alex-snigir/water-controller/README.md

# water-controller
Home Main Water Line Controller connects directly to primary water supply to monitor flow, detect leaks, and automatically shut off the water to prevent catastrophic property damage.
