alex-snigir/water-controller/WaterController_pio/README.txt

Project: WaterController

  Home Main Water Line Controller connects directly to primary water supply to monitor flow, 
  detect leaks, and automatically shut off the water to prevent catastrophic property damage.
 
  Versions:
    v1.00 build 20261031 - Initial version
    v1.00 build 20261108 - Lock Switch J7 (GPIO13, valve/lock) and software open ban valve_enable (NVS, valve_enable/set), valve/rejected
    v1.00 build 20261109 - LED4 tells rejected opens apart: 3 fast blinks "locked", 2 long blinks "disabled";
                           retained valve/open, valve/close, valve_enable/set deleted on MQTT connect, before subscribing

  TODO:
