alex-snigir/water-controller/doc/water-connection-project-summary.md

# WaterController — сводка проекта

Версия документа: 1.0 · Дата: 2026-10-20

> Контроллер главного водопровода дома: подключается к магистральному вводу воды, контролирует расход и давление, обнаруживает протечки и автоматически перекрывает воду, чтобы предотвратить серьёзный ущерб.

| | |
|---|---|
| Схема | `schematics/WaterController/WaterController.kicad_sch` (KiCad 10.0.3, 1 лист A4) |
| Нетлист | `schematics/WaterController/plot/WaterController.net` (экспорт 2026-11-13 23:04) |
| PDF схемы | `schematics/WaterController/plot/WaterController.pdf` |
| Прошивка | `WaterController_pio/` (PlatformIO, Arduino), `APP_VER = "1.00 build 20261031"` |
| Исходные заметки | `doc/WaterController - INFO.txt`, `doc/Water Connection.txt` |
| Плата (PCB) | не начата (`WaterController.kicad_pcb` пустой) |

---

## 1. Структура системы

```
          +12V от HLK-10M12 (отдельная плата) ──► J8 ──► F1 + D1 (защита)
              │
     ┌────────┼──────────────────────────────┬──────────────────────┐
     │        │                              │                      │
     │   LM2596 (MOD1) ──► 1N5817 (D2) ──► +5V                      │
     │                                       │                      │
     │      ┌────────────────────────────────┼─────────────┐        │
     │      │                                │             │        │
     │   ESP32-DevKitC-32U (U1)          ADS1115 (U4)   HV-сторона  │
     │   5V-пин → LDO → +3V3             VDD = 5V       Level       │
     │      │                                │          Shifter(U2) │
     │      │ IO21/IO22 (I2C, 3.3V) ──► U2 ──► SDA/SCL               │
     │      │ IO19/IO18 ──►|── D3/D4 ──────► IN1/IN2 ──► DRV8871 (U3)│
     │      │ SW1/SW2 (кнопки) ─► IN1/IN2    │                       │
     │      │ IO34/IO35 ◄─ R7/R8 ◄─ IN1/IN2  │                       │
     │      │ IO32/33/25/26 ─► LED1–LED4     │                       │
     │      │ IO5/IO15 ◄── J4/J5 (DS18B20)   │                       │
     │      │ IO21/IO22 ──► J6 (SHT41, 3.3V) │                       │
     │      │ IO13 ◄── J7 (Lock Switch)      │                       │
     │      │                                │             VM=+12V ─┘
     │      │                                │             OUT1/OUT2
     │      │                          A0 ◄── J2 ◄── SWP-300       │
     │      │                                       (питание +12V)  ▼
     │      │ IO23 ◄── U2 ◄── R13 ◄── J3 ◄── YF-B10 (+5V)    J1 ──► Кран CR01
     │      │                                                      (CWX-25S)
     │      │                                     LED5/LED6 (Open/Close) на J1
     │   Wi-Fi (внешняя антенна) ──► MQTT-брокер ──► Home Assistant
```

---

## 2. Оборудование

### 2.1 Микроконтроллер

| Параметр | Значение |
|---|---|
| Модуль | ESP32-WROOM-32U (разъём U.FL под внешнюю антенну) |
| Отладочная плата на схеме | ESP32-DevKitC-32U, 38 выводов (символ `_my_MC_Dev_Boards:ESP32-DEVKITC-32-38PINS`) |
| Питание | 5 В на вывод `5V` платы, 3.3 В получается встроенным LDO платы |
| Почему 5 В | 5 В — единое напряжение для периферии: ADS1115 питается от 5 В, чтобы диапазон его входа покрывал сигнал датчика давления 0–5 В |

### 2.2 Электрокран

| Параметр | Значение |
|---|---|
| Модель | CR01, 12 В, DN20 (3/4"), модель CWX-25S |
| Управление | 2 провода, направление — сменой полярности |
| Особенность | в открытом и закрытом положении ток не потребляет (сохраняет положение при пропадании питания) |
| Питание | 12 В |
| Мощность | < 2 Вт |
| Рабочий ток | < 80 мА (только во время хода) |
| Время полного хода | 5 с |
| Концевики | встроены: в крайних положениях кран сам обесточивает мотор |
| Обратная связь о положении | нет: 2-проводная модель, выводов состояния концевиков нет |

### 2.3 Электронный датчик давления

| Параметр | Значение |
|---|---|
| Модель | SWP-300, 0–10 бар, G1/2 |
| Подключение | 1/2" папа |
| Питание | 12–36 В DC (номинал 24 В); на схеме — **+12 В** |
| Выход | 0–5 В (линейно: 2 бар/В) |

### 2.4 Датчик расхода

| Параметр | Значение |
|---|---|
| Модель | YF-B10, 1", 2–50 л/мин |
| Питание | DC 3.5–24 В (датчик Холла, питание обязательно); на схеме — **+5V** (J3) |
| Выход | импульсы, 476 имп/л |
| Частота | при 50 л/мин ≈ 400 Гц; при 2 л/мин ≈ 16 Гц |

### 2.5 Механический манометр

Резьба 1/4" папа, ставится на тот же тройник, что и электронный датчик (визуальный контроль).

### 2.6 Датчики температуры и влажности

| Датчик | Где | Подключение | Назначение |
|---|---|---|---|
| DS18B20, герметичный зонд в гильзе | **Pipe** — на латунном фитинге или корпусе крана, под теплоизоляцией | J4, 1-Wire, GPIO5 | риск замерзания, нагрев воды |
| DS18B20, герметичный зонд | **Air** — воздух в большом уличном боксе, в тени, не касаясь трубы и стенок | J5, 1-Wire, GPIO15 | условия вокруг оборудования; примерная температура стенок для оценки конденсата |
| SHT41 (модуль на кабеле 10–20 см) | **Box** — воздух внутри коробки контроллера, вдали от HLK, LM2596, ESP32 | J6, I2C (0x44) | перегрев электроники, влажность, точка росы |
| SHTC3 | для испытаний вместо SHT41 | J6, I2C (0x70) | нагревателя нет |
| Датчик ESP32 | кристалл | — | только справочно (см. 4.7) |

### 2.7 Блок питания и корпус

| Параметр | Значение |
|---|---|
| Источник 12 В | Hi-Link **HLK-10M12** (AC → 12 В) на **отдельной монтажной плате**; к плате контроллера — двумя проводами через J8 (винтовой клеммник). LM2596 остаётся на плате контроллера |
| Корпус контроллера | закрытая коробка 12 × 17 × 9 см с платой контроллера и платой БП; стоит внутри большого уличного бокса со всей водяной системой |
| Рекомендация | **HLK-10M12**: пиковая нагрузка по 12 В ~4 Вт (ход крана + пик Wi-Fi) — почти весь номинал 5-ваттного модуля, а при высокой температуре допустимая мощность таких модулей снижается (кривую проверить в даташите Hi-Link) |
| Плата БП | клеммник 220 В (L, N), предохранитель T 0.5–1 А на L, варистор ~275 В AC (10D471 / 14D471), HLK-10M12, на выходе электролит 100–220 мкФ + 100 нФ (обвязку сверить с даташитом HLK-10M12); зазор между цепями 220 В и низковольтной частью ≥ 6 мм, лишние полосы и площадки монтажной платы разрезать, сторону 220 В закрыть |
| Тепло | в коробке выделяется ~1 Вт → примерно +5…10 °C к воздуху в боксе; летом закрытый бокс на солнце может нагреваться до 60 °C и выше — светлый бокс, тень, коробка не у солнечной стенки |

---

## 3. Гидравлическая схема подключения (из `Water Connection.txt`)

**Пиллер (на улице):** счётчик → обратный клапан (аль-хозер) → ручной кран → труба PEX25 до хацера.

**Хацер, версия 1 (по потоку воды):**

| # | Элемент | Резьба |
|---|---|---|
| 1 | Труба PEX25 | — |
| 2 | Переходник PEX25 → 3/4 | 3/4 мама → папа |
| 3 | Ручной кран | 3/4 мама → папа |
| 4 | **Электрокран CR01** | 3/4 мама → мама |
| 5 | Переходник 3/4 → 1" | 1" папа → папа |
| 6 | **Датчик расхода YF-B10** | 1" мама → мама |
| 7 | Переходник 1" → 3/4 | 3/4 папа → мама |
| 8 | Вассат (редуктор давления) | 3/4 папа → папа |
| 9 | Фильтр | 3/4 мама → мама |
| 10 | Ручной кран | 3/4 папа → мама |
| 11 | Тройник | 3/4 → 3/4 |
| 12 | Переходник 3/4 → PEX25 | 3/4 мама → мама |

**Отвод от тройника (п. 11):** тройник 3/4 + заглушка → переходник 3/4 → 1/2 → **электронный датчик давления** (1/2) и механический манометр (1/4).

Датчик давления стоит после редуктора и фильтра, то есть измеряет давление в домашней сети.

---

## 4. Электрическая схема (по нетлисту)

### 4.1 Перечень элементов

| Обозн. | Номинал / модуль | Футпринт | Назначение |
|---|---|---|---|
| J8 | PWR 12V, Conn_01x02 | винтовой клеммник MaiXu MX126, 5.0 мм (`TerminalBlock_MaiXu_MX126-5.0-02P`) | ввод 12 В от платы HLK-10M12: 1 — GND, 2 — +12V_IN |
| F1 | RXEF075 (самовосстанавливающийся предохранитель, 0.75 А удержания) | `Fuse:Fuse_Bourns_MF-RHT050`, шаг 5.1 мм — совпадает с RXEF075 | последовательно в +12V: +12V_IN → +12V |
| D1 | P6KE18A (TVS, однонаправленный) | DO-15 | +12V → GND (катод к +12V): гасит выбросы и вместе с F1 защищает от переполюсовки |
| MOD1 | LM2596 (модуль HW-411) | `_my_PSU_Modules:DC-DC Step Down LM2596 HW-411` | понижающий DC-DC 12 → 5 В; входной электролит модуля — 100 мкФ, 50 В |
| D2 | 1N5817 | DO-41 | развязка выхода LM2596 и шины +5V (защита от обратного тока при питании DevKit от USB) |
| U1 | ESP32-DevKitC-32U, 38 pin | `_my_MC_Dev_Boards:ESP-DEVKIT-32-38PINS` | МК |
| U2 | 4-канальный I2C Logic Level Converter | `_my_Generic_Modules:IIC_I2C_4-way_Logic_Level_Converter` | 3.3 В ↔ 5 В: канал 1 — сигнал датчика расхода, канал 2 — SCL, канал 3 — SDA; канал 4 свободен |
| U3 | DRV8871 H-Bridge Motor Driver Module | `_my_Generic_Modules:DRV8871 H-Bridge Motor Driver Module on perfboard` | драйвер электрокрана |
| U4 | ADS1115 (синий модуль) | `_my_ADC_DAC_Modules:ADS1115_Blue_Module_Horizontal` | АЦП 16 бит для датчика давления |
| J1 | Conn_01x02 | JST XH 2P, вертикальный (B2B) | кран CR01: 1 — Valve_Red (OUT1), 2 — Valve_Black (OUT2) |
| J2 | Conn_01x03 | JST XH 3P, вертикальный (B3B) | датчик давления: 1 — GND, 2 — +12V, 3 — сигнал |
| J3 | Conn_01x03 | JST XH 3P, вертикальный (B3B) | датчик расхода YF-B10: 1 — GND, 2 — +5V, 3 — сигнал |
| C2 | 470 мкФ | радиальный D8 | +5V (у вывода 5V DevKit) |
| C1 | 100 нФ | керамика | +5V (у вывода 5V DevKit) |
| C3 | 470 мкФ | радиальный D8 | +3V3 |
| C4 | 100 нФ | керамика | +3V3 |
| C7 | 100 нФ | керамика | VDD ADS1115 |
| C5 | 100 мкФ, 35 В | радиальный D8 | VM DRV8871 (+12V); 35 В — с запасом выше ограничения D1 (~25 В) |
| C6 | 100 нФ | керамика | VM DRV8871 (+12V) |
| R1 | 4.7 кОм | R_Axial DIN0207, P7.62 мм | последовательный резистор в линии сигнала датчика давления: ограничение тока через защитные диоды A0, RC-фильтр с C8 |
| R2 | 100 кОм | R_Axial DIN0207, P7.62 мм | подтяжка сигнала датчика давления к GND (со стороны J2): определённый уровень 0 В при отключённом датчике |
| C8 | 100 нФ | керамика | фильтр на входе A0 ADS1115 (A0 → GND), RC-фильтр с R1 |
| R3 | 47 кОм | R_Axial DIN0207, P7.62 мм | подтяжка valve_close (IO18 / DRV8871 IN2) к GND |
| R4 | 47 кОм | R_Axial DIN0207, P7.62 мм | подтяжка valve_open (IO19 / DRV8871 IN1) к GND |
| D3 | 1N5817 | DO-41 | развязка IO19 → IN1: GPIO может только подать 1, кнопка SW1 не замыкается на выход GPIO |
| D4 | 1N5817 | DO-41 | развязка IO18 → IN2: то же для SW2 |
| SW1 | SW_Push (Open) | JST XH 2P (B2B-XH-A), вертикальный | выносная кнопка без фиксации «открыть»: подаёт питание кнопок на IN1 |
| SW2 | SW_Push (Close) | JST XH 2P (B2B-XH-A), вертикальный | выносная кнопка без фиксации «закрыть»: подаёт питание кнопок на IN2 |
| R5 | 7.5 кОм | R_Axial DIN0207, P7.62 мм | верхнее плечо делителя питания кнопок (от +5V); ограничение тока при замыкании провода кнопки |
| R6 | 15 кОм | R_Axial DIN0207, P7.62 мм | нижнее плечо делителя питания кнопок (≈ 3.33 В) |
| C9 | 100 нФ | керамика | фильтр узла питания кнопок (R5/R6) |
| C10 | 100 нФ | керамика | фильтр входа IN1 (помехи, статика, дребезг SW1) |
| C11 | 100 нФ | керамика | фильтр входа IN2 (помехи, статика, дребезг SW2) |
| R7 | 10 кОм | R_Axial DIN0207, P7.62 мм | чтение состояния IN1 на IO34; ограничение тока в защитные диоды ESP32 |
| R8 | 10 кОм | R_Axial DIN0207, P7.62 мм | чтение состояния IN2 на IO35; ограничение тока в защитные диоды ESP32 |
| D5 | LED1 (WIFI), синий | LED 5 мм, угловой (LED_D5.0mm_Horizontal) | статус Wi-Fi/MQTT, катод на IO32 |
| D6 | LED2 (Valve), зелёный | LED 5 мм, угловой | состояние крана, катод на IO33 |
| D7 | LED3 (Flow), жёлтый | LED 5 мм, угловой | расход, катод на IO25 |
| D8 | LED4 (Error), красный | LED 5 мм, угловой | ошибка, катод на IO26 |
| R9 | 200 Ом | `_my_Resistors:R_Axial_DIN0207…P10.16` | токоограничивающий для D5 (от +3V3) |
| R10 | 240 Ом | `_my_Resistors:R_Axial_DIN0207…P10.16` | токоограничивающий для D6 (от +3V3) |
| R11 | 510 Ом | `_my_Resistors:R_Axial_DIN0207…P10.16` | токоограничивающий для D7 (от +3V3) |
| R12 | 510 Ом | `_my_Resistors:R_Axial_DIN0207…P10.16` | токоограничивающий для D8 (от +3V3) |
| R13 | 1 кОм | R_Axial DIN0207, P7.62 мм | последовательный резистор в сигнале датчика расхода: RC-фильтр с C12, ограничение тока при статике |
| C12 | 10 нФ | керамика | фильтр сигнала датчика расхода (Water_Flow → GND) |
| D9 | LED5 (Open), зелёный | LED 5 мм, угловой | индикация команды «открыть» на выходе DRV8871 (OUT1 → OUT2) |
| D10 | LED6 (Close), красный | LED 5 мм, угловой | индикация команды «закрыть» на выходе DRV8871 (OUT2 → OUT1) |
| R14 | 2.2 кОм | `_my_Resistors:R_Axial_DIN0207…P10.16` | общий токоограничивающий для D9/D10 (от выхода крана 12 В) |
| J4 | Conn_01x03 | штыри 1×3, 2.54 мм (Dupont) | зонд DS18B20 Pipe: 1 — DQ (IO5), 2 — GND, 3 — +3V3 |
| J5 | Conn_01x03 | штыри 1×3, 2.54 мм (Dupont) | зонд DS18B20 Air: 1 — DQ (IO15), 2 — GND, 3 — +3V3 |
| J6 | Conn_01x04 | JST XH 4P, вертикальный (B4B) | модуль SHT41 (Box): 1 — +3V3, 2 — GND, 3 — SCL (IO22), 4 — SDA (IO21) |
| R15 | 4.7 кОм | `_my_Resistors:R_Axial_DIN0207…P10.16` | подтяжка 1-Wire DQ (IO5, J4) к +3V3 |
| R16 | 4.7 кОм | `_my_Resistors:R_Axial_DIN0207…P10.16` | подтяжка 1-Wire DQ (IO15, J5) к +3V3 |
| J7 | Conn_02x02_Odd_Even | штыри 2×2, 2.54 мм (`PinHeader_2x02_P2.54mm_Vertical`) | Lock Switch: 1 — узел IN1, 2 — IN1 у DRV8871, 3 — LOCK (→ R19 → IO13), 4 — GND; норма — перемычки 1–2 и 3–4 |
| R17 | 47 кОм | R_Axial DIN0207, P7.62 мм | подтяжка IN1 к GND на стороне DRV8871 (при разомкнутом J7 1–2) |
| C13 | 100 нФ | керамика | фильтр IN1 на стороне DRV8871 |
| R18 | 10 кОм | R_Axial DIN0207, P7.62 мм | подтяжка LOCK (IO13) к +3V3 |
| R19 | 1 кОм | R_Axial DIN0207, P7.62 мм | последовательно в линии LOCK: ограничение тока статики с кабеля переключателя |
| C14 | 100 нФ | керамика | фильтр IO13 на GND (с R19: τ = 0.1 мс) |
| NT1, NT2 | NetTie_2 | — (on_board = no, in_bom = no) | только рисунок перемычек J7 1–2 и 3–4; в нетлист и на плату не попадают |

### 4.2 Цепи питания

| Цепь | Источник | Потребители |
|---|---|---|
| +12V_IN | J8.2 (от HLK-10M12) | только F1 |
| +12V | после F1 | D1, MOD1 IN+, U3 VM, J2.2 (питание датчика давления), C5, C6 |
| +5V | MOD1 OUT+ через D2 | U1 `5V` (вывод 19), U2 HV, U4 VDD, R5 (питание кнопок), J3.2 (питание YF-B10), C1, C2, C7 |
| +3V3 | LDO на плате DevKit (U1 вывод 1) | U2 LV, R9–R12 (светодиоды D5–D8), J4.3/J5.3 (DS18B20), R15/R16, J6.1 (SHT41), R18 (LOCK), C3, C4 |
| GND | общая (J8.1) | все модули; U1 выводы 14, 32, 38 |

PWR_FLAG стоят на +12V_IN, +12V (после F1), +5V (после D2) и GND: F1 и D2 пассивные, и без флага после них ERC считал бы, что у входов питания MOD1, U3 и U1 нет источника.

### 4.2.1 Ввод питания 12 В и защита (J8, F1, D1)

```
HLK-10M12 ── J8.2 ── +12V_IN ──[F1 RXEF075]──┬──────────┬──────────┬──────────┬──── +12V
(отдельная                                    │          │          │          │
 плата)                                    D1 P6KE18A  MOD1 IN+   U3 VM      J2.2
                                              │       (LM2596)  (DRV8871,  (датчик давления)
                                              │                  C5, C6)
          ── J8.1 ── GND ─────────────────────┴──────────────────────────────────── GND
```

| Режим | Что происходит |
|---|---|
| Обычная работа | D1 закрыт (рабочее напряжение P6KE18A без утечки — 15.3 В, запас ~3 В над 12.0–12.5 В от HLK); падение на F1 ≈ 0.1 В при ~0.35 А |
| Выброс с длинных кабелей к крану и датчику | D1 ограничивает напряжение на шине: начинает открываться при 17.1–18.9 В, при пиковом токе ограничивает на ~25 В |
| Перепутана полярность на J8 | D1 открывается в прямом направлении и замыкает вход: срабатывает F1 (и ограничение тока HLK), на схеме не больше ~−1 В |

- **Порядок важен:** D1 — сразу после F1, все нагрузки — после D1. TVS до предохранителя при переполюсовке пропускал бы ток мимо F1.
- Последовательный диод от переполюсовки не ставится: падение 0.3–0.5 В опустило бы питание датчика давления ниже его минимума 12 В.
- **Выдерживают ~25 В на шине:** DRV8871 (VM до 45 В), LM2596 (до 40 В), SWP-300 (12–36 В), C5 (35 В), входной электролит модуля LM2596 (50 В), C6 (керамика, обычно 50 В).
- **Почему клеммник, а не XH:** XH 2P уже стоят на J1 (кран) и SW1/SW2 (кнопки) — кабель 12 В вошёл бы в них (12 В на входы DRV8871 сожгли бы драйвер). Клеммник с XH не перепутать; от переполюсовки защищают F1 и D1.
- **Шелкография:** у J8 крупно «+12V» и «GND», лучше со стрелкой полярности.
- **Разводка:** J8, F1 и D1 — рядом; путь от D1 к U3 VM и C5 — коротким и широким проводником (ток мотора крана).

### 4.3 Сигнальные цепи

| Цепь | От | Через | К |
|---|---|---|---|
| I2C SCL | U1 IO22 (выв. 36) | U2 LV2 → HV2; на стороне LV — J6.3 | U4 SCL, SHT41 SCL |
| I2C SDA | U1 IO21 (выв. 33) | U2 LV3 → HV3; на стороне LV — J6.4 | U4 SDA, SHT41 SDA |
| valve_open | U1 IO19 (выв. 31) | D3; на узле IN1 — R4 47 кОм и C10 100 нФ на GND, SW1 | U3 IN1 |
| valve_close | U1 IO18 (выв. 30) | D4; на узле IN2 — R3 47 кОм и C11 100 нФ на GND, SW2 | U3 IN2 |
| Питание кнопок | +5V | делитель R5 7.5 кОм / R6 15 кОм, C9 100 нФ на GND | SW1.2, SW2.2 |
| IN1 → DRV8871 | узел IN1 (Net-(D3-K), J7.1) | J7 1–2 (перемычка или контакт A переключателя); на стороне DRV8871 — R17 47 кОм и C13 100 нФ на GND | U3 IN1 (Net-(J7-Pin_2)) |
| LOCK | J7.3 | R19 1 кОм; R18 10 кОм к +3V3; C14 100 нФ на GND; J7.4 — GND | U1 IO13 (выв. 15), вход |
| Состояние IN1 | узел IN1 (Net-(D3-K)) | R7 10 кОм | U1 IO34 (выв. 5), вход |
| Состояние IN2 | узел IN2 (Net-(D4-K)) | R8 10 кОм | U1 IO35 (выв. 6), вход |
| Кран | U3 OUT1 / OUT2 | — | J1.1 / J1.2 |
| LED5/LED6 | U3 OUT1 | R14 2.2 кОм → D9 / D10 (встречно-параллельно) | U3 OUT2 |
| LED1–LED4 | +3V3 | R9–R12 → анод D5–D8 | катоды на U1 IO32, IO33, IO25, IO26 |
| Давление | J2.3 | R2 на GND → R1 → C8 на GND | U4 A0 |
| Расход (Water_Flow) | J3.3 | R13 1 кОм → C12 10 нФ на GND → U2 HV1 → LV1 | U1 IO23 (выв. 37) |
| 1-Wire Pipe | J4.1 | R15 4.7 кОм к +3V3 | U1 IO5 (выв. 29) |
| 1-Wire Air | J5.1 | R16 4.7 кОм к +3V3 | U1 IO15 (выв. 23) |

Не подключены: U2 LV4/HV4 (свободный канал преобразователя уровней); U4 A1–A3, ADDR (на синем модуле есть подтяжка к GND → адрес 0x48, совпадает с `ADS1X15_ADDRESS` в прошивке), ALRT; остальные GPIO ESP32 (см. раздел 9).

### 4.3.1 Входная цепь датчика давления (R1, R2, C8)

```
J2.3 (сигнал) ──┬──[R1 4.7 кОм]──┬──► A0 (U4, ADS1115)
                │                │
            [R2 100 кОм]     C8 100 нФ
                │                │
GND ────────────┴────────────────┴──► GND (U4)
```

| Цепь (нетлист) | Узлы |
|---|---|
| Net-(J2-Pin_3) | J2.3, R1.1, R2.1 |
| Net-(U4-A0) | R1.2, C8.2, U4.7 (A0) |
| GND | J2.1, R2.2, C8.1, U4.2 |

| Элемент | Назначение | Расчёт |
|---|---|---|
| R1 4.7 кОм | Ограничивает ток через внутренние защитные диоды A0 (допустимо ≤ 10 мА), если на сигнальный провод попадёт +12 В (ошибка в разъёме, повреждение кабеля) | (12 − 5.3) В / 4.7 кОм ≈ 1.4 мА; мощность на R1 ≈ 10 мВт |
| C8 100 нФ | Вместе с R1 — RC-фильтр нижних частот: подавляет помехи с длинного кабеля (мотор крана, сеть, Wi-Fi) и отдаёт заряд на коммутируемый вход ADS1115 при каждом преобразовании. Ставится у вывода A0, земля — к GND модуля ADS1115 | fc = 1 / (2π · 4.7 кОм · 100 нФ) ≈ 340 Гц; установление 5τ ≈ 2.4 мс < 8 мс (одно преобразование при 128 SPS) |
| R2 100 кОм | Подтяжка к GND со стороны разъёма: при отключённом датчике вход не «плавает», а показывает 0 В | нагрузка на выход датчика 100 кОм — пренебрежимо мала |

- Ошибка измерения от R1: входное сопротивление ADS1115 на диапазоне ±6.144 В ~10 МОм → ≈ 0.05 %, меньше погрешности датчика.
- При перевёрнутом 3-контактном разъёме +12 В остаётся на среднем контакте и на A0 не попадает.
- Опционально: сдвоенный диод Шоттки BAT54S в узел A0 (на +5V и GND) — внешняя фиксация перенапряжения вместо внутренних диодов ADS1115. Стабилитрон 5.1 В не рекомендуется: его ток утечки около 5 В занижает показания у верхней границы шкалы (10 бар).
- Обрыв датчика по-прежнему не отличим от 0 бар (выход 0–5 В); R2 только устраняет «плавающий» вход.

### 4.3.2 Входная цепь датчика расхода (J3, R13, C12, U2 канал 1)

```
J3.3 ──[R13 1k]──┬── U2 HV1 ══ LV1 ──► IO23
                 │
              C12 10n
                 │
J3.1 ────────────┴── GND        J3.2 ── +5V (питание YF-B10)
```

| Цепь (нетлист) | Узлы |
|---|---|
| Net-(J3-Pin_3) | J3.3, R13.1 |
| /Water_Flow | R13.2, C12.2, U2 HV1 |
| Net-(U1-IO23) | U2 LV1, U1 IO23 |
| +5V | J3.2 |
| GND | J3.1, C12.1 |

| Элемент | Назначение |
|---|---|
| +5V на J3.2 | Питание датчика Холла YF-B10 (3.5–24 В). +3V3 не подходит (ниже минимума 3.5 В); +12V возможен, но выход датчика тогда доходит до 12 В — без пользы и с большим риском |
| U2, канал 1 | Приводит сигнал 0/5 В к 0/3.3 В для IO23 (GPIO ESP32 не выдерживают 5 В). Подтяжки 10 кОм модуля к 5 В (HV) и к 3.3 В (LV) обеспечивают работу и с выходом «открытый коллектор», и с выходом, который сам выдаёт 0/5 В. Сигнал не инвертируется |
| R13 1 кОм | Вместе с C12 — фильтр помех с кабеля; ограничивает ток при статическом разряде |
| C12 10 нФ | Фильтр сигнала на стороне HV |

| Параметр | Значение |
|---|---|
| Частота сигнала | 476 имп/л: ≈ 16 Гц при 2 л/мин, ≈ 400 Гц при 50 л/мин (полупериод 1.25 мс) |
| Фронт вниз (через R13) | τ = 1 кОм · 10 нФ ≈ 10 мкс |
| Фронт вверх (через подтяжку 10 кОм модуля U2) | τ ≈ 100 мкс — в 12 раз меньше полупериода на 400 Гц |
| Уровень 0 при выходе «открытый коллектор» | 5 В · 1 кОм / (10 кОм + 1 кОм) ≈ 0.45 В — ниже порога 0 у ESP32 (0.83 В) |
| Ток датчика | ≤ ~15 мА от +5V |

- Прошивка: `WATER_FLOW_GPIO 23`, `INPUT_PULLUP` (не мешает — подтяжка к 3.3 В уже есть на модуле), прерывание по `FALLING` — подходят.
- Почему IO23, а не IO17: GPIO17 по умолчанию — TX у UART2 (подписан TX2 на DevKit) и оставлен под Serial2 для второго ESP; кроме того, на модуле ESP32-WROVER (с PSRAM) GPIO16/17 заняты памятью, а IO23 свободен. IO23 — не strapping-вывод, без подтяжек при сбросе, поддерживает прерывание.
- Тип выхода конкретного экземпляра можно проверить: питание 5 В, сигнал ни к чему не подключён, прокрутить крыльчатку. Меняется 0/5 В — выход сам выдаёт уровень; «плавает» или около 0 — открытый коллектор. Схема работает в обоих случаях.
- J2 и J3 — одинаковые разъёмы JST XH 3P с одинаковым порядком контактов, но на среднем контакте разное питание: 12 В и 5 В. Перепутывание неопасно (YF-B10 выдерживает 12 В, ток в A0 ограничит R1; SWP-300 при 5 В просто не будет работать), но разъёмы стоит подписать на шелкографии: «PRESS 12V» / «FLOW 5V».

### 4.4 Логика управления краном (DRV8871)

Входы IN1/IN2 управляются от IO19/IO18 без преобразователя уровней, через диоды Шоттки D3/D4: порог VIH у DRV8871 ≈ 1.5 В, уровня ≈ 3.1 В (3.3 В минус падение на диоде) достаточно. Параллельно МК входами управляют кнопки SW1/SW2 (см. 4.4.1). Линия IN1 проходит к DRV8871 через J7 1–2 (Lock Switch, см. 4.4.3); IN2 — напрямую.

| IN1 (IO19 или SW1) | IN2 (IO18 или SW2) | Выход | Действие |
|---|---|---|---|
| 0 | 0 | Z (coast), через ~1 мс — сон | стоп |
| 1 | 0 | OUT1 = +12V, OUT2 = GND | открытие |
| 0 | 1 | OUT1 = GND, OUT2 = +12V | закрытие |
| 1 | 1 | оба на GND (brake) | стоп (торможение) |

Во время сброса/загрузки ESP32 выводы IO18/IO19 находятся в высокоимпедансном состоянии (это не strapping-выводы), внешние подтяжки R4 (IN1) и R3 (IN2) по 47 кОм к GND, параллельно внутренним подтяжкам DRV8871, выставляют оба входа в 0 (D3/D4 при этом закрыты) → режим coast, затем сон → **кран при перезагрузке не двигается**. Это корректное безопасное поведение.

R3/R4 задают уровень 0 и тогда, когда плата ESP32 не установлена, и не зависят от наличия внутренних подтяжек в конкретном модуле DRV8871; кроме того, они повышают помехоустойчивость входов. Нагрузка на GPIO в состоянии 1: 3.3 В / 47 кОм ≈ 70 мкА на каждый вывод (вместе с внутренней подтяжкой DRV8871 — порядка 0.1 мА), что пренебрежимо мало.

### 4.4.1 Ручное управление краном (SW1, SW2, D3, D4, R3–R8, C9–C11)

Реализует требование `INFO.txt` «Ability to open/close Electrical Water Valve without MC (phisical buttons)»: выносные кнопки без фиксации подают 1 прямо на входы DRV8871, минуя ESP32. Ручное управление работает, даже если ESP32 завис, не загружен или плата DevKit не установлена: питание кнопок берётся от +5V (LM2596), а не от LDO DevKit.

```
                      +5V
                       │
                   [R5 7.5k]
                       │  ≈ 3.33 В
              ┌────────┼────────┬───────────────┐
              │        │        │               │
          [R6 15k]  C9 100n   [SW1 Open]     [SW2 Close]
              │        │        │               │
             GND      GND       │               │
                                │               │
IO19 ──►|── D3 ─────────────────┼──► IN1 (U3)   │
                                │               │
                 IO34 ◄─[R7 10k]┤               │
                        R4 47k ─┤               │
                       C10 100n ┘ → GND         │
                                                │
IO18 ──►|── D4 ─────────────────────────────────┼──► IN2 (U3)
                                                │
                                 IO35 ◄─[R8 10k]┤
                                        R3 47k ─┤
                                       C11 100n ┘ → GND
```

| Цепь (нетлист) | Узлы |
|---|---|
| /valve_open | U1 IO19, D3 A |
| Net-(D3-K) — IN1 | D3 K, R4, C10, R7.2, SW1.1, U3 IN1 |
| /valve_close | U1 IO18, D4 A |
| Net-(D4-K) — IN2 | D4 K, R3, C11, R8.1, SW2.1, U3 IN2 |
| Net-(C9-Pad1) — питание кнопок | R5.2, R6.1, C9, SW1.2, SW2.2 |
| /IO34 | U1 IO34, R7.1 |
| /IO35 | U1 IO35, R8.2 |
| +5V | R5.1 |
| GND | R3.2, R4.2, R6.2, C9, C10, C11 |

**Назначение элементов**

| Элемент | Назначение |
|---|---|
| D3, D4 (1N5817) | GPIO может только подать 1 на IN, но не притянуть его к 0. Если кнопка нажата при GPIO = 0, диод закрыт и кнопка не замыкается на выход GPIO. Заодно диод не пропускает на GPIO напряжение выше 3.3 В. Диод со стороны кнопки не нужен: кнопка либо разомкнута, либо подаёт то же питание кнопок |
| R3, R4 (47 кОм) | Подтяжка IN2/IN1 к 0, когда GPIO = 0 (через закрытый диод GPIO вход к 0 не притянет), при загрузке ESP32 и при отпущенной кнопке |
| R5, R6 (7.5 / 15 кОм) | Делитель от +5V: питание кнопок ≈ 3.33 В, независимо от LDO DevKit. R6 = 15 кОм выбран так, чтобы при нажатии уровень на IN был с запасом выше порога 1 у ESP32 (чтение через IO34/IO35). R5 ограничивает ток, если провод кнопки замкнёт на GND |
| C9 (100 нФ) | Фильтр узла питания кнопок; при нажатии отдаёт заряд в C10/C11 |
| C10, C11 (100 нФ) | Фильтр входов IN1/IN2 от наводок и статики с проводов выносных кнопок, подавление дребезга контактов |
| R7, R8 (10 кОм) | Подключают узлы IN1/IN2 к входам IO34/IO35 для чтения состояния. Ограничивают ток в защитные диоды ESP32 при статике с проводов кнопок. На уровень узла не влияют (вход GPIO высокоомный). Подтяжки для IO34/IO35 не нужны — их роль выполняют R4/R3 |
| SW1, SW2 | Кнопки без фиксации, разъёмы JST XH 2P: pin 1 — IN, pin 2 — питание кнопок. Тумблер с фиксацией не годится: в положении OPEN вход IN1 постоянно в 1, и при протечке команда МК на закрытие даст только brake — кран не закроется |

**Уровни** (порог DRV8871: VIH ≈ 1.5 В, VIL ≈ 0.5 В; порог ESP32: VIH = 0.75 · 3.3 ≈ 2.48 В, VIL = 0.25 · 3.3 ≈ 0.83 В)

| Режим | IN / IO34 (IO35) | Запас до VIH ESP32 |
|---|---|---|
| Питание кнопок, кнопки отпущены | 5 · 15 / (7.5 + 15) ≈ 3.33 В | — |
| GPIO = 1 (через D3/D4; падение на 1N5817 при ~0.1 мА ≈ 0.15–0.2 В) | ≈ 3.1 В | ≈ 0.6 В |
| Нажата одна кнопка (R6 ∥ R4 ∥ внутренняя подтяжка DRV8871 ~100 кОм ≈ 10.2 кОм) | ≈ 2.9 В (≈ 3.0 В без внутренней подтяжки) | ≈ 0.4 В |
| Нажаты обе кнопки | ≈ 2.5 В на обоих входах → brake, кран стоит | ≈ 0.07 В — на грани, но режим и так нерабочий |
| Всё отпущено, GPIO = 0 | 0 В (R3/R4) | — |

| Параметр | Значение |
|---|---|
| Запас по 1 для DRV8871 | более 1 В во всех режимах |
| Максимум на IO34/IO35 | ≤ 3.3 В |
| Обратное напряжение на D3/D4 (кнопка нажата, GPIO = 0) | ≈ 2.9 В, ток утечки — единицы мкА |
| Ток при замыкании провода кнопки на GND | 5 В / 7.5 кОм ≈ 0.67 мА — питание ESP32 не просядет |
| Постоянный ток делителя | 5 В / 22.5 кОм ≈ 0.22 мА |

**Динамика**

| Событие | Что происходит | Время |
|---|---|---|
| МК даёт 1 | GPIO заряжает C10/C11 через открытый диод | микросекунды |
| МК даёт 0 | Диод закрыт, C10/C11 разряжаются через R4/R3 ∥ внутреннюю подтяжку (≈ 32 кОм), τ ≈ 3.2 мс | ниже VIL ESP32 (0.83 В) через ≈ 4–6 мс; ниже VIL DRV8871 (0.5 В) через ≈ 6–9 мс |
| Нажатие кнопки | C9 делит заряд с C10 — вход сразу ≈ 1.7 В, затем дозаряд через R5, τ ≈ 0.9 мс | до ≈ 2.9 В за ≈ 2–3 мс |
| Отпускание кнопки | Разряд через R4/R3 | ≈ 6–9 мс |
| Узел питания кнопок | R5 ∥ R6 = 5 кОм с C9, τ ≈ 0.5 мс | фильтр помех на проводе |

На входах IN частота среза фильтра около 50 Гц: короткие наводки на кабеле кнопок не доходят до порога 1.5 В.

**Поведение**

- Кран движется, пока кнопка нажата. У CR01 есть встроенные концевики: кнопку можно держать до конца хода, в крайнем положении кран обесточится сам.
- Нажатие кнопки во время встречного хода по команде МК → brake на ~30 мс (антидребезг), затем прошивка снимает свой выход, и кран идёт по кнопке. Команды при нажатой кнопке игнорируются. Обе кнопки сразу → brake, кран стоит. Это безопасно.
- Задержка остановки 6–9 мс из-за C10/C11 ни на что не влияет: CR01 останавливается концевиками, прошивка — по таймеру 7 с.
- При реверсе прошивка снимает выход и включает противоположный через 20 мс (`VALVE_REVERSE_PAUSE_MS`, без блокировки `loop()`): за это время C10/C11 разряжаются, поэтому brake на 1–9 мс, когда оба входа в 1, не возникает.

**Чтение состояния прошивкой (IO34/IO35)**

| IO34 (IN1) | IO19 (свой выход) | Значит |
|---|---|---|
| 0 | 0 | кнопка Open не нажата |
| 1 | 0 | нажата кнопка Open |
| 1 | 1 | кран открывает МК |
| 0 | 1 | ошибка: выход в 1, а на узле 0 (обрыв D3, КЗ узла IN1 на GND) |

Для IO35 / IO18 (Close) — аналогично. Требования к прошивке:

- **Маскирование после выключения выхода.** Когда МК переводит IO19/IO18 в 0, C10/C11 разряжаются, и ≈ 4–6 мс вход остаётся в 1. Чтобы хвост собственной команды не был принят за нажатие, после выключения выхода вход нужно игнорировать ~20 мс.
- **Антидребезг:** 20–50 мс программно (C10/C11 уже сглаживают основной дребезг).
- GPIO34/35 — только входы, без внутренних подтяжек: `pinMode(VALVE_OPEN_STATUS, INPUT)`, `pinMode(VALVE_CLOSE_STATUS, INPUT)` (макросы в `Application.h`).
- Реализовано в `valve.cpp` (см. 7.2, п. 14).

**Размещение на плате:** C10/C11 — рядом с разъёмами SW1/SW2, куда приходит провод кнопки, чтобы статический разряд уходил в конденсатор раньше, чем дойдёт до DRV8871; C9 — рядом с R5/R6; R7/R8 — ближе к выводам IO34/IO35. Порядок контактов SW1/SW2 (pin 1 — IN, pin 2 — питание кнопок) подписать на шелкографии.

### 4.4.2 Индикация команды на кран (LED5, LED6: D9, D10, R14)

```
OUT1 ──[R14 2.2k]──┬──►|── D9  LED5 (Open, зелёный)  ──┬── OUT2
                   └──|◄── D10 LED6 (Close, красный) ──┘
```

| Цепь (нетлист) | Узлы |
|---|---|
| Net-(J1-Pin_1) — OUT1 | U3 OUT1, J1.1, R14.2 |
| Net-(D10-K) | R14.1, D9 A, D10 K |
| Net-(D10-A) — OUT2 | U3 OUT2, J1.2, D9 K, D10 A |

| Режим DRV8871 | Горит | Ток |
|---|---|---|
| Open: OUT1 = +12V, OUT2 = GND | D9 LED5 (Open) | (12 − 2.0) / 2.2 кОм ≈ 4.5 мА |
| Close: OUT2 = +12V, OUT1 = GND | D10 LED6 (Close) | ≈ 4.5 мА |
| Coast / сон / brake | ничего | 0 |

- Светодиоды стоят на выходе DRV8871, поэтому показывают команду независимо от источника — кнопка SW1/SW2 или МК — и не нагружают логические узлы IN1/IN2. Подключение к узлам IN через 240 Ом (первый вариант) «садило» узел при нажатии кнопки до ≈ 1.8–2.0 В: IO34/IO35 переставали видеть нажатие, а запас DRV8871 падал до 0.3–0.5 В.
- Обратное напряжение на погашенном светодиоде равно падению на горящем (≈ 2 В) — меньше допустимых 5 В.
- Мощность на R14 ≈ 45 мВт; добавка к току DRV8871 несущественна.
- Светодиоды показывают поданное напряжение, а не движение крана: когда встроенный концевик CR01 обесточит мотор, светодиод горит, пока подана команда (до 7 с от прошивки или пока нажата кнопка).

### 4.4.3 Блокировка открытия — Lock Switch (J7, R17–R19, C13, C14)

Назначение: физически запретить открытие крана — и командой МК, и кнопкой SW1. Закрыть кран можно всегда. Случаи: работа сантехника после крана, долгий отъезд, защита от ошибочных или случайных команд (Home Assistant, retained-сообщение, ошибка прошивки). Для ремонта по-прежнему надёжнее всего ручной шаровой кран перед электрокраном.

```
Узел IN1 (D3, SW1, R4, C10, R7) ── J7.1 ○─┐ A ○─ J7.2 ──┬────────── U3 IN1
                                           │             ├─[R17 47k]── GND
                                           │             └─[C13 100n]─ GND
                                           │ (механически связаны)
+3V3 ──[R18 10k]──┬──[R19 1k]── J7.3 ○─────┘ B ○─ J7.4 ── GND
                  └─[C14 100n]─ GND
                  │
                IO13
```

| Цепь (нетлист) | Узлы |
|---|---|
| Net-(D3-K) — узел IN1 | D3 K, SW1.1, R4, C10, R7, **J7.1** |
| Net-(J7-Pin_2) — IN1 у DRV8871 | **J7.2**, U3 IN1, R17, C13 |
| Net-(J7-Pin_3) — LOCK | **J7.3**, R19 |
| /IO13 | U1 IO13, R19, R18, C14 |
| GND | **J7.4**, R17, C13, C14 … |

**Работа**

| J7 | IN1 к DRV8871 | IO13 | Состояние |
|---|---|---|---|
| перемычки 1–2 и 3–4 / переключатель в «Normal» | подключён | **0** | открытие разрешено |
| перемычек нет / переключатель в «LOCK» | оторван (R17 держит 0) | **1** (R18) | открытие невозможно ни МК, ни кнопкой SW1; закрытие работает |
| кабель переключателя выдернут или оборван | оторван | **1** | то же, что LOCK — прошивка не «думает», что открывает, когда открыть нельзя |

- Выносной переключатель — **DPST** (две независимые группы контактов, механически связанные): группа A разрывает IN1 (J7 1–2), группа B соединяет LOCK с GND (J7 3–4). Кабель — 4 провода с колодкой Dupont 2×2.
- Блокируется только IN1 (открытие); IN2 (закрытие) идёт мимо J7.
- Узел IN1 со стороны кнопки цел и при блокировке: IO34 видит нажатие SW1, но кран не движется; LED5 (Open) не загорается — наглядная обратная связь.
- R17/C13 нужны, потому что при разомкнутом J7 1–2 вывод IN1 у DRV8871 отрезан от R4/C10; без них остаётся только внутренняя подтяжка DRV8871 (~100 кОм) без фильтра — выносной провод мог бы наводкой кратко поднять IN1 выше ~1.5 В.
- Распределение контактов безопасно при ошибке: если перемычки надеть вертикально (1–3, 2–4), IN1 у DRV8871 окажется на GND (кран не откроется), а IO13 = 1 («заблокировано»).
- **NT1/NT2** — Net Tie без футпринта и с «on_board» = no: только рисунок перемычек, в нетлист не попадают (цепи J7.1/J7.2 и J7.3/J7.4 раздельны — так и нужно). Футпринт им не назначать: на плате появилась бы постоянная перемычка медью, и J7 потерял бы смысл.
- **При сборке:** без джамперов на J7 кран не откроется, а прошивка покажет `locked` — надеть перемычки 1–2 и 3–4 сразу.
- **Шелкография:** «LOCK», две горизонтальные чёрточки на месте перемычек; на схеме у J7 — заметка «Normal: jumpers on 1–2 and 3–4 / LOCK: remove jumpers or connect DPST switch».
- Ограничение: если перемычки стоят несогласованно (одна снята), состояние IO13 не совпадёт с реальным состоянием IN1. Прошивка это обнаружить не может (нет датчика положения); с переключателем DPST такого не бывает.
- **Ошибки монтажа, найденные на макете** (схема и нетлист верны, исправлено 20261109) — при разводке и сборке платы проверить эти соединения:
  - J7.3 не был соединён с R19 → IO13 всегда 1, прошивка всегда показывала `locked` (безопасный отказ);
  - R7 (к IO34) стоял на стороне J7.2 (IN1 у DRV8871) вместо узла J7.1 (D3 K / SW1 / R4 / C10) → при снятых перемычках IO34 не видел SW1, при замкнутых всё работало. Аналогично проверить, что R17/C13 стоят на стороне J7.2: ошибку R17 на стороне J7.1 в работе не видно, но IN1 при блокировке остаётся без подтяжки и фильтра.

### 4.5 Распределение GPIO: схема, прошивка и заметки

| GPIO | Схема (нетлист) | Прошивка (`Application.h`) | `INFO.txt` |
|---|---|---|---|
| 21 | SDA → U2 LV3/HV3 → ADS1115; SHT41 (J6.4) | `I2C_SDA_GPIO` | SDA: LV3 → HV3 → ADS1115; SDA SHT41 |
| 22 | SCL → U2 LV2/HV2 → ADS1115; SHT41 (J6.3) | `I2C_SCL_GPIO` | SCL: LV2 → HV2 → ADS1115; SCL SHT41 |
| 19 | valve_open → D3 → DRV8871 IN1 | `VALVE_OPEN_PIN` (выход) | Valve open (H-Bridge) |
| 18 | valve_close → D4 → DRV8871 IN2 | `VALVE_CLOSE_PIN` (выход) | Valve close (H-Bridge) |
| 34 | IN1 → R7 → IO34 (вход, состояние Open) | `VALVE_OPEN_STATUS` (`valve.cpp`) | Physical button/IN1 (open valve) status |
| 35 | IN2 → R8 → IO35 (вход, состояние Close) | `VALVE_CLOSE_STATUS` (`valve.cpp`) | Physical button/IN2 (close valve) status |
| 23 | J3.3 → R13 → U2 HV1/LV1 → IO23 | `WATER_FLOW_GPIO` (INPUT_PULLUP, прерывание FALLING) | Water Flow: LV1 → HV1 → J3 |
| 5 | J4 DQ, подтяжка R15 4.7 кОм — DS18B20 Pipe | `TEMP_PIPE_GPIO` (`temperature.cpp`) | Water Pipe temperature (DS18B20) |
| 15 | J5 DQ, подтяжка R16 4.7 кОм — DS18B20 Air | `TEMP_AIR_GPIO` (`temperature.cpp`) | Air temperature (DS18B20) |
| 13 | J7.3 → R19 → IO13 (вход, Lock Switch), R18 10 кОм к +3V3, C14 на GND | `VALVE_LOCK_GPIO` (`INPUT` без подтяжки, `valve.cpp`, антидребезг 50 мс) | Lock Switch J7 (input, 1 = locked, R18 pull-up) |
| 16 | не подключён (резерв) | — | reserved for Serial2 RX (2nd ESP) |
| 17 | не подключён (резерв) | — | reserved for Serial2 TX (2nd ESP) |
| 32 | D5 LED1 (WIFI), активный LOW | `TEST_WIFI_LED` (`connectionMonitor`, `LED_PULLUP`) | LED1 Wi-Fi/MQTT (синий), pull-up |
| 33 | D6 LED2 (Valve), активный LOW | `VALVE_LED` (`valve.cpp`) | LED2 состояние крана (зелёный), pull-up: горит — открыт, не горит — закрыт, мигает — движется, короткая вспышка раз в 2 с — положение неизвестно |
| 25 | D7 LED3 (Flow), активный LOW | `FLOW_LED` (не используется) | LED3 расход (жёлтый), pull-up |
| 26 | D8 LED4 (Error), активный LOW | `ERROR_LED` (`alarms.cpp`) | LED4 ошибка (красный), pull-up: горит — активно предупреждение, медленно мигает (1 с) — датчик температуры или коробки в статусе `error`/`no_sensor`, двойная короткая вспышка раз в 2 с — открытие запрещено (J7 или `valve_enable` = 0), 3 быстрые вспышки — открытие отклонено блокировкой J7 (`locked`), 2 длинные вспышки — отклонено `valve_enable` = 0 (`disabled`), не горит — всё в порядке |
| ? | — | `AC_POWER_DETECT_GPIO ?` | наличие сетевого питания (UPS) |

⚠ — расхождение, подробности в разделе 7.

### 4.6 Светодиоды индикации (D5–D8, R9–R12)

```
+3V3 ──[R9 200]──►|── D5 LED1 WiFi  (синий)   ──► IO32
+3V3 ──[R10 240]─►|── D6 LED2 Valve (зелёный) ──► IO33
+3V3 ──[R11 510]─►|── D7 LED3 Flow  (жёлтый)  ──► IO25
+3V3 ──[R12 510]─►|── D8 LED4 Error (красный) ──► IO26
```

Светодиод горит при 0 на выводе (активный LOW) — это совпадает с `LED_PULLUP` в `connectionMonitor`. По сравнению с подключением «GPIO → LED → GND» схема электрически равноценна: у ESP32 ток в 0 (до ~28 мА) и в 1 (до ~40 мА) с большим запасом перекрывает ток светодиода. Плюс — единообразие с библиотекой и другими проектами SmartHome. При загрузке выводы в высокоимпедансном состоянии, светодиоды не горят. GPIO32/33/25/26 — не strapping-выводы.

| LED | Резистор | Падение на LED при 1–5 мА | Ток |
|---|---|---|---|
| D5 WiFi (синий) | 200 Ом | ≈ 2.6–2.8 В | ≈ 2–3 мА |
| D6 Valve (зелёный) | 240 Ом | ≈ 1.9–2.0 В (обычный) / ≈ 2.6–2.7 В (InGaN) | ≈ 5 мА / ≈ 2 мА |
| D7 Flow (жёлтый) | 510 Ом | ≈ 1.9–2.0 В | ≈ 2.5 мА |
| D8 Error (красный) | 510 Ом | ≈ 1.8 В | ≈ 2.7 мА |

Расчёт: I = (3.3 − 0.1 − падение на LED) / R, где 0.1 В — остаточное напряжение на выводе GPIO в 0. Суммарно от +3V3 — не более ~12 мА.

- Резисторы подобраны под цвет: яркость всех четырёх примерно одинакова. Если обычный зелёный окажется ярче остальных, R10 можно увеличить до 510 Ом.
- Яркость синего сильнее всего зависит от экземпляра — проверить на макете; если тусклый, R9 = 100–150 Ом.
- В прошивке: включение — `LOW`; при инициализации сначала `digitalWrite(pin, HIGH)`, затем `pinMode(pin, OUTPUT)`, чтобы светодиод не мигнул при старте.
- LED5/LED6 (Open/Close) — без GPIO, на выходе DRV8871, см. 4.4.2.
- LED7 (Power) из `INFO.txt` на схеме нет: его можно подключить к +5V через резистор без GPIO — индикация питания от LM2596.

---

### 4.7 Датчики температуры и влажности (J4, J5, J6, R15, R16)

```
+3V3 ──[R15 4.7k]──┬── IO5  ── J4.1 DQ   J4: DQ / GND / +3V3  → зонд DS18B20 Pipe
+3V3 ──[R16 4.7k]──┬── IO15 ── J5.1 DQ   J5: DQ / GND / +3V3  → зонд DS18B20 Air

IO22 (SCL) ── J6.3   IO21 (SDA) ── J6.4   J6: +3V3 / GND / SCL / SDA → модуль SHT41 (Box)
```

| Цепь (нетлист) | Узлы |
|---|---|
| /IO5 | U1 IO5, R15.1, J4.1 |
| /IO15 | U1 IO15, R16.1, J5.1 |
| /IO22 | U1 IO22, U2 LV2, J6.3 |
| /IO21 | U1 IO21, U2 LV3, J6.4 |
| +3V3 | J4.3, J5.3, J6.1, R15.2, R16.2 … |
| GND | J4.2, J5.2, J6.2 … |

**DS18B20 (J4, J5)**

- Каждый датчик на своём GPIO: замыкание или вода в кабеле одного зонда не выводит из строя другой; при замене зонда не нужно перенастраивать адреса — роль определяется разъёмом. В прошивке на каждой шине один датчик, можно обращаться без адреса (Skip ROM).
- GPIO5 и GPIO15 — strapping-выводы, которым при загрузке нужна 1; линия 1-Wire в покое подтянута к 1 (R15/R16), это совпадает. Даже при замыкании кабеля зонда на GND загрузка не сорвётся: 0 на GPIO15 только отключает загрузочный вывод в консоль, GPIO5 при обычной загрузке ни на что не влияет.
- Питание датчиков +3V3 по отдельному проводу (без «паразитного» режима): уровни совпадают с ESP32, преобразователь не нужен.
- **GND в середине разъёма** (DQ / GND / +3V3): у Dupont нет ключа; если надеть зонд наоборот, земля остаётся на месте — датчик не ответит, но не получит обратную полярность.
- ⚠ Колодку Dupont 3P, вероятно, можно надеть и на штыри J2 (XH 3P, где 12 В) — DS18B20 выдерживает максимум 6 В. При разводке поставить J4/J5 подальше от J2/J3 и подписать на шелкографии: «PIPE: DQ GND 3V3», «AIR: DQ GND 3V3», «PRESS 12V».
- Зонд на трубе крепить к латунному фитингу или корпусу крана (PEX плохо проводит тепло): термопаста, хомут, сверху утеплитель.

**SHT41 (J6)**

- Сторона LV у U2 (3.3 В), подтяжки шины — 10 кОм модуля U2 к 3.3 В (и подтяжки самого модуля SHT). Через U2 это одна логическая шина с ADS1115.
- Порядок J6 (+3V3 / GND / SCL / SDA) совпадает с распиновкой большинства модулей SHT; у XH есть ключ, а других 4-контактных XH на плате нет.
- Модуль — на кабеле 10–20 см, в воздухе коробки, а не над платой: иначе он покажет нагрев HLK, LM2596 и ESP32.
- SHT41 выбран вместо BME280: точнее по влажности (±1.8 % против ±3 %), лучше держит долгую высокую влажность, есть нагреватель для просушки после конденсата; давление воздуха в проекте не нужно. У SHT41 по сравнению с SHT40 меньше худшая ошибка у краёв шкалы влажности (±2.5 % против ±3.5 %).

**Адреса I2C**

| Адрес | Устройство |
|---|---|
| 0x48 | ADS1115 (ADDR на GND через подтяжку модуля) |
| 0x44 | SHT41-AD1B (самый распространённый вариант) |
| 0x45 | SHT41-BD1B |
| 0x70 | SHTC3 (для испытаний) |

**Внутренний датчик ESP32.** У классического ESP32 он плохо откалиброван и показывает температуру кристалла, нагретого Wi-Fi; на многих экземплярах `temperatureRead()` возвращает постоянные ~53.3 °C. Публиковать только как справочное значение, если на вашем экземпляре оно меняется, и не использовать для автоматических действий.

**Требования к прошивке** (реализованы: DS18B20 в `temperature.cpp`, SHT41/SHTC3 в `box_sensor.cpp` — без библиотеки Adafruit, см. 7.2, п. 16):
- DS18B20: `OneWire` + `DallasTemperature` на каждый GPIO; `setWaitForConversion(false)`, запуск обоих одновременно, чтение через 750 мс по `millis()`; разрешение 12 бит; −127 и 85 °C считать ошибкой.
- SHT41: библиотека Adafruit SHT4x (для SHTC3 — Adafruit SHTC3); запуск измерения и чтение через `millis()` (~10 мс); выбор датчика макросом в `Application.h`; при влажности > ~85–90 % — редкий короткий нагрев (~1 с), температуру после нагрева несколько секунд не читать.
- Опрос раз в минуту. MQTT — в стиле существующих топиков, например: `temperature/pipe`, `temperature/air`, `temperature/chip`, `box/temperature`, `box/humidity`, `box/dewpoint`, `temperature/status` (retained, по каждому датчику).
- Предупреждения: ✅ вычисляются в прошивке (`alarms.cpp`) с гистерезисом и публикуются retained в `alarm/freeze` (труба < 3 °C, сброс > 4 °C), `alarm/overheat` (коробка > 55 °C, сброс < 50 °C), `alarm/condensation` (`temperature/air` − `box/dewpoint` < 2 °C, сброс > 3 °C): `on`, `off`, `unknown` (нет данных нужного датчика); LED4 горит при активном предупреждении. Уведомления — автоматизациями Home Assistant по этим топикам. Прошивка ничего не делает с краном.

## 5. Бюджет питания (оценка)

| Потребитель | Шина | Ток | Примечание |
|---|---|---|---|
| ESP32 DevKit | 5 В | ~70 мА средн., пики до ~300–400 мА | пики при передаче Wi-Fi |
| LM2596, холостой ход (LED модуля) | 12 В | ~8 мА | из `INFO.txt` |
| ADS1115 + level shifter | 5 В | < 1 мА | |
| Светодиоды D5–D8 | 3.3 В (LDO DevKit) | ≤ ~12 мА | все горят одновременно |
| YF-B10 | 5 В | ≤ 15 мА | через J3 |
| Датчик давления SWP-300 | 12 В | ≤ 50 мА | значение из `INFO.txt` |
| Кран CR01 | 12 В | < 80 мА | только во время хода (~7 с) |
| DRV8871 | 12 В | ~3 мА (`INFO.txt`) | в покое микросхема уходит в сон |
| LED5/LED6 (D9/D10) | 12 В (выход DRV8871) | ≈ 4.5 мА | только пока подана команда на кран |
| DS18B20 ×2 + SHT41 | 3.3 В | < ~3 мА | только во время измерения, в покое — микроамперы |

Итого по 12 В: ~100 мА в покое и ~250–350 мА в пике (ход крана + пик Wi-Fi), то есть до ~4 Вт. Выбран HLK-10M12 (см. 2.7): у HLK-5M12 запас почти нулевой, особенно при летнем нагреве коробки.

В `INFO.txt` вариант на реле (18 мА + 25 мА при 12 В) вынесен в отдельный блок «not used»: в схеме реле заменены на DRV8871.

---

## 6. Прошивка

### 6.1 Сборка

```sh
pio run -e RELEASE_OTA_esp32dv                 # сборка
pio run -e RELEASE_OTA_esp32dv -t upload       # прошивка по OTA (хост "watercontroller1")
pio run -e RELEASE_COM_esp32dv -t upload       # прошивка по COM7
pio device monitor -e RELEASE_COM_esp32dv      # монитор, 115200
```

Переменные окружения: `SMARTHOME_WIFI_SSID`, `SMARTHOME_WIFI_PWD`, `SMARTHOME_MQTT_BROKER`, `SMARTHOME_OTA_PASSWD` (и варианты `_OFFICE`).
Библиотеки: ArduinoJson ~6.19.4, PubSubClient ~2.8, Adafruit ADS1X15 ^2.5.0.

### 6.2 Архитектура

- Кооперативный неблокирующий super-loop: `loop()` по очереди вызывает `handleClient()` / `*_handle()` всех модулей; все задержки сделаны на `millis()`.
- `src/lib/` — общая инфраструктура проектов SmartHome: `wifiConnect`, `mqttClient`, `otaClient` (владеет mDNS), `connectionMonitor`, `serialDebug`, `profiler`, `Log`, `TimeUtils`.
- Прикладные модули:

| Модуль | Функция |
|---|---|
| `valve.cpp` | H-мост: открытие/закрытие подачей 1 на IN1/IN2, автостоп через `valve_move_time_mills = 7000` мс; пауза 20 мс при реверсе (`VALVE_REVERSE_PAUSE_MS`); чтение кнопок через IO34/IO35 (маскирование 20 мс, антидребезг 30 мс); состояние крана (`valve/state`), ручные действия (`valve/manual`); LED2; Lock Switch J7 на IO13 (антидребезг 50 мс, `valve/lock`) и программный запрет открытия `valve_enable` (NVS, `Preferences`), отказ — `valve/rejected` (см. 6.4) |
| `ads.cpp` | ADS1115 (gain 2/3, ±6.144 В, 0.1875 мВ/бит), одиночное преобразование с таймаутом 50 мс; при пропаже устройства повторная инициализация раз в минуту |
| `pressure_sensor.cpp` | канал A0, `бар = В × 2`, 0–10 бар; публикация каждые 10 с (`%.2f`); статус датчика `pressure/status`: `ok`, `over_range` (≥ 10 бар), `no_adc` (3 неудачных чтения подряд), `out_of_range`, `unknown`; `pressure/get` — последнее измерение без нового чтения АЦП |
| `water_flow.cpp` | прерывание по спаду на GPIO23 (`WATER_FLOW_GPIO`), подсчёт импульсов под `portMUX`; раз в 60 с — расход в л/мин (= импульсы / 476) и накопленный объём `flowtotal`; ответ на `flowrate/get` |
| `temperature.cpp` | DS18B20 Pipe (GPIO5) и Air (GPIO15), по датчику на шину; опрос раз в 60 с без блокировки: запуск преобразования, чтение через 800 мс по `millis()`; `temperature/pipe`, `temperature/air` (`%.2f`); статусы `temperature/pipe/status`, `temperature/air/status` (retained): `unknown`, `ok`, `no_sensor`, `error` (3 неудачных чтения подряд: −127 или 85 °C); `temperature/get` |
| `box_sensor.cpp` | SHT41 (0x44) на шине I2C с ADS1115, напрямую через `Wire` без библиотеки Adafruit (она ждёт измерение через `delay()`, нагреватель — 1.1 с); SHTC3 для испытаний — `BOX_SENSOR` в `Application.h`. Опрос раз в 60 с без блокировки: команда измерения, чтение через 10 мс по `millis()`, проверка CRC; `box/temperature` (`%.2f`), `box/humidity` (`%.1f`), `box/dewpoint` (формула Магнуса); статус `box/status` (retained): `unknown`, `ok`, `no_sensor`, `error` (3 неудачи подряд); `box/get`. Нагреватель SHT41: 110 мВт, 1 с, после измерения с влажностью ≥ 90 %, не чаще раза в 30 мин; измерение после нагрева отбрасывается, следующее — через минуту |
| `alarms.cpp` | предупреждения `alarm/freeze`, `alarm/overheat`, `alarm/condensation` (retained, `on`/`off`/`unknown`, с гистерезисом) по последним значениям `temperature.cpp` и `box_sensor.cpp`; `alarm/low_pressure`: кран открыт ≥ 30 с и давление < 0.5 бар ≥ 30 с (сброс > 1 бар или кран не открыт); `alarm/get`; LED4: горит при предупреждении, медленно мигает при неисправном датчике, двойная вспышка раз в 2 с — открытие запрещено, при отказе в открытии: 3 быстрые вспышки — `locked`, 2 длинные — `disabled` |
| `debug.cpp` | команды серийной консоли: `wifi_reconnect`, `wifi_set_11b/g/n`, `wifi_info`, `mqtt_info`, `valve_info` (в т.ч. `lock`, `valve_enable`), `valve_enable_0`, `valve_enable_1`, `sensors_info`, `restart` |

- Время: SNTP `pool.ntp.org`, часовой пояс Израиля.

### 6.3 MQTT API (`<area>/<host>` = `home/watercontroller1`)

| Топик | Направление | Описание |
|---|---|---|
| `home/announcement/watercontroller1` | ← | `connected` — при подключении, перед подпиской на топики; `disconnected` — last will от брокера |
| `home/keepalive/watercontroller1` | ← | `connected` раз в минуту |
| `home/alive/get` → `home/alive` | → / ← | базовая информация (JSON) |
| `home/watercontroller1/info/get` → `.../info` | → / ← | расширенная информация + история соединений, `lock`, `valveEnable` |
| `home/watercontroller1/connection/info` | ← | после восстановления MQTT (те же поля, что `info`) |
| `home/watercontroller1/valve/open` | → | открыть кран (payload игнорируется); только при IO13 = 0 и `valve_enable` = 1, иначе `valve/rejected` |
| `home/watercontroller1/valve/close` | → | закрыть кран (payload игнорируется); работает при любой блокировке |
| `home/watercontroller1/valve/state/get` → `.../valve/state` | → / ← | состояние крана, retained: `unknown`, `opening`, `open`, `closing`, `closed`; публикуется при каждом изменении и при подключении к MQTT |
| `home/watercontroller1/valve/manual` | ← | ручное действие: `open`, `close` (нажатие SW1/SW2), `released` (отпускание) |
| `home/watercontroller1/pressure` | ← | давление, бар (строка `%.2f`) |
| `home/watercontroller1/pressure/get` | → | запрос давления: последнее измерение, без нового чтения АЦП |
| `home/watercontroller1/pressure/status` | ← | состояние датчика, retained: `unknown`, `ok`, `over_range` (10 бар и выше, публикуется 10), `no_adc` (АЦП потерян: 3 неудачных чтения подряд), `out_of_range`; при изменении, при подключении к MQTT и в ответ на `pressure/get`, если действующего значения нет |
| `home/watercontroller1/flowrate` | ← | расход, л/мин (каждые 60 с) |
| `home/watercontroller1/flowrate/get` | → | запрос расхода: последнее рассчитанное значение, 0 до конца первых 60 с |
| `home/watercontroller1/flowtotal` | ← | литры с момента загрузки (строка `%.3f`, каждые 60 с), после перезагрузки считает с 0 |
| `home/watercontroller1/valve_enable/get` | → | запрос `valve_enable` |
| `home/watercontroller1/valve_enable` | ← | программное разрешение открытия, retained: `1` / `0`; при изменении, в ответ на `valve_enable/set` и `valve_enable/get`, при подключении к MQTT |
| `home/watercontroller1/valve_enable/set` | → | `1` — разрешить, `0` — запретить открытие командами МК (RETAIN=false); кнопку SW1 не блокирует; хранится в NVS, по умолчанию `1`; другой payload, в т.ч. пустой, игнорируется |
| `home/watercontroller1/valve/lock` | ← | аппаратная блокировка J7 (IO13), retained: `locked` / `unlocked`; при изменении, при подключении к MQTT и в ответ на `valve/lock/get` |
| `home/watercontroller1/valve/lock/get` | → | запрос `valve/lock` |
| `home/watercontroller1/valve/rejected` | ← | отказ в открытии (RETAIN=false): `locked` — `valve/open` или кнопка SW1 при блокировке J7; `disabled` — `valve/open` при `valve_enable` = 0 |

---

### 6.4 Задание на реализацию: Lock Switch и `valve_enable`

✅ **Реализовано** в прошивке 1.00 build 20261108 (`valve.cpp`, `alarms.cpp`, `main.cpp`, `debug.cpp`), подробности — 7.2 п. 17; команда консоли — `valve_enable_0` / `valve_enable_1` (консоль не принимает аргументы). ✅ Проверка на железе (п. 10) пройдена полностью 20261109, все 9 пунктов (обе причины начальных сбоев — ошибки монтажа, см. 4.4.3). Исходное задание (схема — 4.4.3): Делать в стиле существующего кода (неблокирующий super-loop, `millis()`, модули в `src/`, топики-макросы в `main.h`, см. `WaterController_pio/CLAUDE.md`).

**Два независимых механизма запрета открытия**

| | Аппаратный — Lock Switch (J7) | Программный — `valve_enable` |
|---|---|---|
| Кто ставит | человек на месте: перемычки / переключатель DPST | Home Assistant по MQTT; в будущем — логика протечки |
| Что блокирует | открытие и командой МК, и кнопкой SW1 (IN1 физически разорван) | только команды МК (`valve/open` по MQTT и будущие автоматические открытия); **кнопку SW1 не блокирует** — она подаёт IN1 мимо МК |
| Закрытие | всегда работает | всегда работает |
| Как узнаёт прошивка | IO13 = 1 | свой флаг |
| После перезагрузки | по положению J7 | восстанавливается из NVS |

Открытие по команде МК разрешено, только если **IO13 = 0 и `valve_enable` = 1**.

**1. `Application.h`**

```cpp
#define VALVE_LOCK_GPIO        13  // input: J7 Lock Switch sense, 1 = locked (R18 pull-up, R19 + C14 filter)
```

`pinMode(VALVE_LOCK_GPIO, INPUT)` — без внутренней подтяжки (есть внешняя R18).

**2. Чтение Lock Switch**
- Опрос в `valve_handle()`, антидребезг **50 мс**.
- Читать до первой команды после старта (в `valve_init()`), чтобы состояние было известно сразу.
- При изменении — публикация `valve/lock`, лог в Serial.

**3. `valve_enable`**
- Флаг хранится в NVS (`Preferences`, namespace `valve`, key `enable`), по умолчанию **1** (первый запуск — разрешено). Писать в NVS только при изменении (износ flash).
- `valve_enable/set`: payload `1` — разрешить, `0` — запретить; любой другой, в том числе пустой, — игнорировать с записью в лог.
- `valve_enable/get` → ответ в `valve_enable`.

**4. MQTT (добавить топики в `main.h`, подписки в `topics[]`, `TOPIC_COUNT`, ветки в `mqtt_callback()`)**

| Топик | Направление | RETAIN | Payload | Когда |
|---|---|---|---|---|
| `valve/lock` | ← | true | `locked` / `unlocked` | при изменении, при подключении к MQTT, в ответ на `valve/lock/get` |
| `valve/lock/get` | → | false | — | запрос |
| `valve_enable` | ← | true | `1` / `0` | при изменении, при подключении к MQTT, в ответ на `valve_enable/get` |
| `valve_enable/get` | → | false | — | уже подписан, добавить обработчик |
| `valve_enable/set` | → | false | `1` / `0` | команда |
| `valve/rejected` | ← | false | `locked` / `disabled` | открытие отклонено (см. п. 5) |

Префикс всех топиков — `home/watercontroller1/`. Названия `valve_enable` и `valve_enable/get` уже определены в `main.h` (`TOPIC_VALVE_ENABLED`, `TOPIC_VALVE_ENABLED_GET`).

**5. Поведение крана**

| Ситуация | Действие прошивки |
|---|---|
| `valve/open` при IO13 = 1 | не включать IO19; `valve/state` не менять; опубликовать `valve/rejected` = `locked` |
| `valve/open` при `valve_enable` = 0 (и IO13 = 0) | не включать IO19; `valve/state` не менять; `valve/rejected` = `disabled` |
| `valve/close` при любой блокировке | выполнять как обычно |
| Блокировку J7 включили **во время открытия** (по команде МК или кнопкой) | мотор уже остановился (IN1 оторван): снять IO19 (`valve_abort("lock")` или аналог), `valve/state` = `unknown`, опубликовать `valve/lock` |
| Блокировку J7 включили во время закрытия | ничего не делать: закрытие идёт мимо J7 |
| Кнопка Open (SW1) нажата при IO13 = 1 | IO34 видит нажатие, но кран не движется: опубликовать `valve/manual` = `open` и `valve/rejected` = `locked`; **не** переводить `valve/state` в `opening` |
| Кнопка Open нажата при `valve_enable` = 0 (IO13 = 0) | кран **движется** (аппаратно): обрабатывать как обычное ручное открытие — `valve/manual`, `valve/state` |
| `valve_enable` = 0, кран уже открыт | ничего не закрывать: запрет касается только открытия |
| Снятие блокировки / `valve_enable` = 1 | никаких автоматических действий, только публикация нового состояния |

**6. Индикация**
- LED4 (Error, `alarms.cpp`): пока открытие запрещено (IO13 = 1 или `valve_enable` = 0) — двойная короткая вспышка раз в 2 с. Активное предупреждение (`alarm/*`) и ошибка датчиков имеют приоритет.
- При отклонённой команде или нажатии Open под блокировкой — LED4 быстро мигает 3 раза.
- LED5 (Open, аппаратный) при блокировке J7 сам не загорается.

**7. Диагностика**
- `valve_info` (серийная консоль): добавить `lock` (IO13), `valve_enable`.
- В JSON `info` / `connection/info`: поля `lock` и `valveEnable`.
- По желанию — команда консоли `valve_enable 0|1`.

**8. На будущее (при реализации обнаружения протечки, 7.2 п. 7):** при автоматическом закрытии по протечке ставить `valve_enable` = 0 (сохраняется в NVS) с публикацией причины — чтобы Home Assistant или автоматика не открыли кран снова, пока человек явно не разрешит (`valve_enable/set` = 1).

**9. Документация:** в `INFO.txt` добавить строку `GPIO 13+ - Lock Switch J7 (input, 1 = locked, R18 pull-up)` и новые топики в раздел «MQTT Interface»; в этой сводке — перевести строки 6.3 из «план» в реализованные и обновить 7.2 и 8.

**10. Проверка на железе**
1. Перемычки на J7: `valve/lock` = `unlocked`, `valve_enable` = `1`; открытие и закрытие командой и кнопками работают.
2. Снять обе перемычки: `valve/lock` = `locked`; `valve/open` → `valve/rejected` = `locked`, IO19 не включается, LED5 не горит, `valve/state` не меняется; `valve/close` работает.
3. Нажать SW1 при блокировке: `valve/manual` = `open`, `valve/rejected` = `locked`, кран не движется, `valve/state` не `opening`.
4. Снять перемычки во время открытия: мотор останавливается, `valve/state` = `unknown`.
5. `valve_enable/set` = `0`: `valve/open` → `valve/rejected` = `disabled`; `valve/close` работает; SW1 по-прежнему открывает кран, состояние отслеживается.
6. Перезагрузить при `valve_enable` = 0: после старта по-прежнему 0.
7. `valve_enable/set` с пустым payload или `abc` — игнорируется.
8. Переподключение к MQTT: `valve/lock` и `valve_enable` публикуются заново (retained).
9. Выдернуть кабель переключателя: `locked`.

## 7. Результаты анализа

### 7.1 Схема

**Важно**

1. ✅ **Ввод питания 12 В — выполнено:** J8 (винтовой клеммник 5.0 мм) от отдельной платы HLK-10M12, самовосстанавливающийся предохранитель F1 RXEF075 и TVS D1 P6KE18A (выбросы и переполюсовка), C5 100 мкФ / 35 В (см. 4.2.1). Остаётся подписать полярность J8 на шелкографии.
2. ✅ **Датчик расхода YF-B10 — выполнено:** разъём J3 (GND / +5V / сигнал), сигнал через R13 1 кОм и C12 10 нФ, уровень 5 → 3.3 В через канал 1 U2 на IO23 (см. 4.3.2). Остаётся подписать J2/J3 на шелкографии.
3. ✅ **Защита входа A0 ADS1115 — выполнено:** R1 4.7 кОм последовательно + C8 100 нФ на GND (см. 4.3.1). Опционально — BAT54S.
4. **Обрыв датчика давления не отличим от 0 бар.** Выход 0–5 В, 0 бар = 0 В. ✅ Подтяжка R2 100 кОм к GND добавлена — «плавающего» входа нет. Для надёжной диагностики обрыва лучше датчик с выходом 0.5–4.5 В. ✅ Частично: `alarm/low_pressure` (`alarms.cpp`) срабатывает, если при открытом кране давление держится ниже 0.5 бар (норма после редуктора — 4 бар); причину (обрыв, нет питания датчика, нет воды, разрыв трубы) не различает.
5. **Датчик давления питается от 12 В — нижняя граница диапазона 12–36 В.** С учётом допуска БП и падений на кабеле напряжение может опуститься ниже 12 В. Проверить точность при 11.5–12 В; при необходимости — БП 15 В (DRV8871 и LM2596 это допускают) или отдельный повышающий DC-DC. Защита входа на это почти не влияет: F1 отнимает ~0.1 В, последовательного диода нет.
6. **На схеме отсутствуют** светодиод LED7 (Power), кнопка AP/конфигурации, датчик протечки, детектор сетевого питания — все они есть в требованиях (`INFO.txt`). ✅ Кнопки открытия/закрытия (SW1/SW2) добавлены — см. 4.4.1. ✅ Светодиоды LED1–LED4 (D5–D8) добавлены — см. 4.6. ✅ LED5/LED6 (Open/Close) на выходе DRV8871 — см. 4.4.2. ✅ Датчики температуры и влажности: DS18B20 ×2 (J4/J5) и SHT41 (J6) — см. 4.7. ✅ Переключатель блокировки (J7) — см. 4.4.3.
7. ✅ **Футпринты U2, U3, U4 назначены** (свои библиотеки `_my_Generic_Modules`, `_my_ADC_DAC_Modules`; путь в `fp-lib-table` проекта).

**Средне / для сведения**

8. ✅ **Level shifter на входах DRV8871 убран — выполнено:** IN1/IN2 управляются от IO19/IO18 через D3/D4 (VIH DRV8871 ≈ 1.5 В). При сбросе — coast (R3/R4 47 кОм + внутренние подтяжки DRV8871 к GND), кран не двигается. Канал 1 U2 использован под сигнал YF-B10, каналы 2–3 — I2C, канал 4 свободен.
9. **D2 1N5817 снижает +5V примерно на 0.3–0.4 В** (1N5817 заменил 1N5819: падение меньше, обратное напряжение 20 В — для шины 5 В достаточно). Выход LM2596 нужно выставить на ~5.3–5.4 В, чтобы на ADS1115 и HV-стороне было ≥ 4.9 В (иначе сигнал 5 В от датчика превысит VDD ADS1115).
10. **C3 470 мкФ на +3V3** — большая ёмкость на выходе LDO DevKit (увеличивает пусковой ток). Обычно хватает 22–100 мкФ. Не критично.
11. **Нет обратной связи о положении крана.** У CR01 есть встроенные концевики, но это 2-проводная модель без выводов состояния; прошивка «считает» кран открытым/закрытым по последней команде; ручные нажатия SW1/SW2 прошивка читает через IO34/IO35. Варианты: кран с выводами состояния концевиков (модели CR04/CR05) или измерение тока хода через шунт.
12. **При пропадании питания кран остаётся в последнем положении** (вода не перекрывается). Для защиты от протечек при отключении сети — UPS/аккумулятор на 12 В и вход «AC power detect» (уже есть в требованиях).
13. ✅ **Чтение нажатий SW1/SW2 — выполнено в схеме:** узлы IN1/IN2 заведены на входы IO34/IO35 через R7/R8 10 кОм; R6 увеличен до 15 кОм для запаса по уровню (см. 4.4.1). Поддержка в прошивке есть (7.2, п. 14).
14. ✅ **Разъёмы SW1/SW2 — выполнено:** JST XH 2P вертикальные. Порядок контактов (pin 1 — IN, pin 2 — питание кнопок) подписать на шелкографии.
15. ✅ **Переключатель блокировки открытия — выполнено в схеме:** J7 разрывает IN1 у DRV8871 (блокирует и МК, и SW1), состояние читается на IO13; R17/C13 на стороне DRV8871, R18/R19/C14 на линии LOCK (см. 4.4.3). ✅ Прошивка — реализовано (6.4, 7.2 п. 17).
16. **J4/J5 (Dupont) — риск надеть зонд на J2 (12 В).** При разводке разнести J4/J5 и J2/J3 и подписать разъёмы на шелкографии (см. 4.7).

### 7.2 Прошивка

1. ✅ `VALVE_LED` исправлен на 33 — совпадает со схемой (D6). `VALVE_LED` используется в `valve.cpp`, `TEST_WIFI_LED` — в `connectionMonitor`, `ERROR_LED` — в `alarms.cpp`; `FLOW_LED` объявлен, но в коде пока не используется.
2. ✅ Подключение LED согласовано: на схеме анод через резистор к +3V3, катод на GPIO (активный LOW) — как `LED_PULLUP` в прошивке. Устарел только `INFO.txt` («pull-down»). При инициализации LED: сначала `HIGH`, потом `OUTPUT`.
3. `AC_POWER_DETECT_GPIO ?` — заглушка, при первом использовании сломает сборку.
4. ✅ `valve_enable/get` обрабатывается в `mqtt_callback()` (ответ в `valve_enable`), добавлены `valve_enable/set` и `valve/lock/get` (см. 6.4). ✅ `flowrate/get` обрабатывается через `water_flow_get()`.
5. ✅ (защита (2) реализована в 1.00 build 20261109, проверено на железе: retained `valve/close` удаляется при переподключении и повторно не выполняется) Команды `valve/open` / `valve/close` по договорённости публикуются без retain (`RETAIN=false` в `INFO.txt`) — так и должно быть: retained-команда выполнялась бы при каждом переподключении и после каждой перезагрузки, в том числе снова открывала бы кран после аварийного закрытия. Но прошивка случайное retained-сообщение не распознает: PubSubClient не передаёт флаг retain, а payload игнорируется. Защита: (1) выполнять команду только при непустом ожидаемом payload; (2) при подключении, **до** подписки на топики, публиковать в `valve/open` и `valve/close` пустое retained-сообщение — брокер удалит сохранённую команду (после подписки без п. 1 это открыло бы кран); (3) в Home Assistant явно указывать `retain: false`. Реализовано (2): `mqttClient.setClearRetainedTopics()` (`src/lib/MqttClient`, v0.21) при каждом подключении, после announcement и до подписки, публикует пустое retained-сообщение в `valve/open`, `valve/close` и `valve_enable/set` — сохранённая по ошибке команда удаляется и не доходит до прошивки. `valve_enable/set` добавлен, чтобы случайный retained `1` не снимал запрет открытия после каждого переподключения (в будущем — запрет, поставленный логикой протечки). Команда, отправленная с retain, пока устройство на связи, выполнится один раз (как и без retain), а при следующем подключении будет удалена; отправленная с retain, пока устройство offline, не выполнится. (1) не реализовано: смысл payload поменял бы API для Home Assistant (сейчас payload игнорируется), а после (2) окно для retained-команды остаётся только между удалением и подпиской. (3) — на стороне Home Assistant.
6. ✅ Состояние крана публикуется в `valve/state` (вычисляется по командам и удержанию кнопок, датчика положения нет). После загрузки и после неполного хода — `unknown` до завершения полного хода.
7. **Основная функция — обнаружение протечки и автоматическое закрытие — пока не реализована.** Возможные правила: непрерывный расход дольше N минут, расход выше порога, падение давления при закрытом кране, сигнал датчика протечки.
8. ✅ Накопительный счётчик объёма публикуется в `flowtotal` — для Home Assistant (Utility Meter / панель Energy → Water, `state_class: total_increasing`). Обрыв MQTT его не сбрасывает, но счёт хранится в RAM: после перезагрузки начинается с 0, вода за время перезагрузки не учитывается.
9. `ads_voltage_chnnel_get()` ждёт окончания преобразования в цикле с `delay(1)` до 50 мс (обычно ~8 мс) — небольшое нарушение неблокирующего принципа.
10. Давление публикуется каждые 10 с (`pressure_sensor_init(10000L)`), а в требованиях — 15 с / 1 мин.
11. ✅ `board = esp32dev` (Espressif ESP32 Dev Module) в обоих окружениях `platformio.ini` — соответствует железу: ESP32-WROOM-32U с внешней антенной (U.FL), на схеме — отладочная плата ESP32-DevKitC-32U.
12. ✅ `valve_move_time_mills = 7000` при реальном полном ходе CR01 5 с (`INFO.txt`) — запас ~40 %; в крайних положениях мотор обесточивают встроенные концевики.
13. ✅ Реверс крана с паузой 20 мс (`VALVE_REVERSE_PAUSE_MS`, см. 4.4.1): без блокировки `loop()`, через `valve_handle()`.
14. ✅ Чтение кнопок через IO34/IO35 реализовано в `valve.cpp`: `INPUT` без подтяжек, нажатие распознаётся при своём выходе = 0, маскирование 20 мс после выключения выхода, антидребезг 30 мс, публикация в `valve/state` и `valve/manual`. Кнопка приоритетнее прошивки: нажатие отменяет ход по команде, а команды при нажатой кнопке игнорируются. Удержание короче 7 с даёт `unknown`, если кран не был уже в этом положении.
15. ✅ Комментарий в `Application.h` исправлен на `// ESP32: ESP-32U-38PINs:`; для ESP8266 добавлен `#error ESP8266 Not supported`. `WATER_FLOW_GPIO` = 23 — совпадает со схемой.
16. ✅ DS18B20 реализованы в `temperature.cpp`: макросы `TEMP_PIPE_GPIO 5`, `TEMP_AIR_GPIO 15` в `Application.h`, библиотеки `paulstoffregen/OneWire`, `milesburton/DallasTemperature` в `platformio.ini`. ✅ `ADC_SDA_GPIO` / `ADC_SCL_GPIO` переименованы в `I2C_SDA_GPIO` / `I2C_SCL_GPIO`. ✅ SHT41 (и SHTC3 для испытаний) реализованы в `box_sensor.cpp` напрямую через `Wire`, библиотеки Adafruit не нужны. Требования — в 4.7.
17. ✅ Lock Switch (IO13) и программный запрет открытия `valve_enable` реализованы в `valve.cpp` по заданию 6.4: `VALVE_LOCK_GPIO 13` (`INPUT`, антидребезг 50 мс, читается уже в `valve_init()`), `valve/lock` (retained); `valve_enable` в NVS (namespace `valve`, key `enable`, запись только при изменении, по умолчанию 1), `valve_enable/set`, `valve_enable/get`; `valve/open` при запрете не включает IO19 и публикует `valve/rejected` (`locked` / `disabled`), `valve/close` работает всегда. Блокировка J7 во время открытия снимает IO19, `valve/state` = `unknown`. Кнопка SW1 при блокировке: `valve/manual` = `open` + `valve/rejected` = `locked`, состояние не меняется, команда закрытия при этом не блокируется; снятие блокировки при удержанной SW1 считается началом ручного открытия. Запрет `valve_enable` = 0 не прерывает уже идущее открытие. LED4: двойная вспышка раз в 2 с при запрете; при отказе, поверх остальной индикации, — 3 быстрые вспышки по 150 мс для `locked` (0.9 с) и 2 длинные по 400 мс для `disabled` (1.6 с), длинные — чтобы не путать с двойной вспышкой запрета (с 1.00 build 20261109, проверено на железе). Поля `lock` / `valveEnable` в `info` и `connection/info` (JSON-буфер увеличен до 1536 байт). ✅ Проверено на железе 20261109: все пункты 6.4 п. 10, включая блокировку во время открытия командой и кнопкой, сохранение `valve_enable` в NVS после перезагрузки, повторную публикацию `valve/lock` и `valve_enable` при переподключении к MQTT, индикацию LED4.

### 7.3 Расхождения в документации

| Где | Что | Как сейчас |
|---|---|---|
| Инструкции проекта | нетлист в `schematics/WaterController/WaterController.net` | фактически `schematics/WaterController/plot/WaterController.net` |
| `INFO.txt` | Power Consumption: нет итога; «Система полива» — `?? mA / ?V`; нет строки датчиков температуры (< ~3 мА / 3.3 В) | — |
| `INFO.txt` | открытый вопрос «AC Power — What is it??» | вход наличия сети при работе от UPS, см. 7.1 п. 12 |
| `INFO.txt` | `GPIO ??`: датчик протечки, KEY1, AC Power; нет GPIO для кнопки AP | предложения — в разделе 9 |
| `INFO.txt` | LED7 Power: «not yet implemented» | на схеме нет |
| `INFO.txt` | названия датчиков: GPIO15 — «Ambient temperature», в Requirements — «Board Temperature/Humidity» | на схеме — «Air Temperature» и «Box Temperature/Humidity»; лучше везде Pipe / Air / Box (эти же названия пойдут в топики MQTT) |

Остальные расхождения с `INFO.txt` (реле, YF-B10, DS18B20, светодиоды pull-up, GPIO19/18 для H-моста, GPIO34/35, каналы U2, GPIO23, Serial2 на GPIO16/17, LED5/LED6, шины в Power Consumption, GPIO5/15, адреса I2C) исправлены в самом `INFO.txt`.

---

## 8. Статус требований

| Требование | Схема | Прошивка |
|---|---|---|
| Открытие/закрытие крана по MQTT | ✅ | ✅ проверено на железе (`[Tested]` в `INFO.txt`) |
| Физические кнопки открытия/закрытия (в т.ч. без МК) | ✅ SW1/SW2, работают без МК; состояние на IO34/IO35 | ✅ чтение IO34/IO35, `valve/manual`, `valve/state` |
| Переключатель блокировки открытия | ✅ J7 (DPST / перемычки), IO13 | ✅ `valve/lock`, `valve/rejected` (6.4), проверено на железе |
| Программный запрет открытия (`valve_enable`) | — | ✅ NVS, `valve_enable/set`, `valve_enable/get` (6.4), проверено на железе |
| Периодическое чтение расхода | ✅ J3 → IO23 | ✅ (раз в 60 с) |
| Периодическое чтение давления | ✅ | ✅ (10 с) |
| Чтение давления по запросу | ✅ | ✅ (`pressure/get`) |
| Температура трубы / воздуха в боксе | ✅ DS18B20 на J4/J5 (GPIO5/15) | ✅ `temperature.cpp` (раз в 60 с) |
| Температура и влажность в коробке | ✅ SHT41 на J6 (I2C) | ✅ `box_sensor.cpp` (раз в 60 с, точка росы) |
| Внутренняя температура ESP32 | — | ❌ (только справочно, см. 4.7) |
| Датчик протечки | ❌ | ❌ |
| Логика обнаружения протечки и автозакрытия | — | ❌ |
| LED1–LED4 | ✅ D5–D8 | частично: LED1, LED2, LED4 (предупреждения, неисправность датчиков, запрет/отказ открытия); LED3 не используется |
| LED5/LED6 Open/Close | ✅ D9/D10 на выходе DRV8871 | — (GPIO не нужен) |
| LED7 Power | ❌ | — (GPIO не нужен) |
| Кнопка AP/конфигурации | ❌ | ❌ |
| Детектор сетевого питания (UPS) | ❌ | ❌ |
| Расширения: полив (2 крана Netafim), влажность, второй ESP | ❌ | ❌ |

---

## 9. Рекомендации по свободным GPIO (ESP32-WROOM-32U)

Избегать strapping-выводов 0, 2, 12 (IO12 нельзя подтягивать к 1 при загрузке); 5 и 15 использованы под 1-Wire — им при загрузке нужна 1, что совпадает с подтяжкой линии и выводов flash 6–11 (SD0–SD3, CMD, CLK). Уже заняты: 5, 15 (DS18B20 Pipe/Air), 13 (Lock Switch), 23 (датчик расхода), 16, 17 (резерв Serial2 для второго ESP), 18, 19 (кран), 21, 22 (I2C), 34, 35 (чтение состояния кнопок Open/Close), 25, 26, 32, 33 (светодиоды LED1–LED4).

| Функция | Предлагаемый GPIO | Примечание |
|---|---|---|
| Кнопка AP/конфигурации / KEY1 | 39 (VN) | только вход, **нет внутренних подтяжек** — внешние 10 кОм к +3V3 + RC-фильтр |
| Датчик протечки | 36 (VP) | то же; или резистивный датчик через A1 ADS1115 |
| AC power detect | 27 | через делитель/оптопару от входа сетевого БП |
| Второй ESP (Serial2) | RX 16, TX 17 | «родные» выводы UART2: `Serial2.begin(baud)` без переназначения. При переходе на ESP32-WROVER (PSRAM на GPIO16/17) UART2 придётся перенести, например на 4/14 |
| Резерв (полив и др.) | 4, 14 | GPIO14 при загрузке выдаёт кратковременный сигнал — для выходов на внешние устройства не лучший выбор |

**Датчик влажности SHT41** подключён к I2C (GPIO21/22) и своих GPIO не занимает.

**Кнопки Open/Close** реализованы аппаратно и своих выходов GPIO не занимают; их состояние читается через IO34/IO35 (R7/R8 10 кОм, см. 4.4.1).

Вопрос из `INFO.txt` «можно ли использовать input-only GPIO для кнопок»: да, GPIO34–39 подходят для кнопок и для чтения состояний, но только с внешними подтягивающими резисторами (у этих выводов внутренних подтяжек нет). GPIO34/35 уже использованы для кнопок крана (подтяжки — R4/R3), свободными остаются GPIO36 и GPIO39.
