alex-snigir/water-controller/doc/Water Connection.txt

  Пиллер:
  =======
    Cчётчик -> аль-хозер-клапан -> Кран ручной -> Труба PEX25 на хацер =====>
  
  Хацер:
  ======
    Version 1:
	----------
       > Труба PEX25 =====
       > Переходник PEX25->3/4  3/4 Mother->Father
       > Кран ручной   +        3/4 Mother->Father
       > Электрокран            3/4 Mother->Mother
	   > Переходник  3/4->1"    1"  Father->Father
       > Датчик потока          1"  Mother->Mother
	   > Переходник  1"->3/4    3/4 Father->Mother
       > Вассат                 3/4 Father->Father
       > Фильтр                 3/4 Mother->Mother
	   > Кран ручной            3/4 Father->Mother
       > Тройник                3/4                 -> 3/4
       > Переходник 3/4->PEX25  3/4 Mother->Mother

       > от тройника         -> 3/4
       > тройник             -> 3/4 + заглушка
       > Переходник       3/4 -> 1/2      Датчик давления электро
	   > Датчик давления элктро       1/2
       > Датчик давления механический 1/4  

    Version 1:
	----------
       > Труба PEX25 =====
       > Переходник PEX25->3/4  3/4 Mother->Mother
