alex-snigir/water-controller/schematics/WaterController/plot/WaterController.pdf

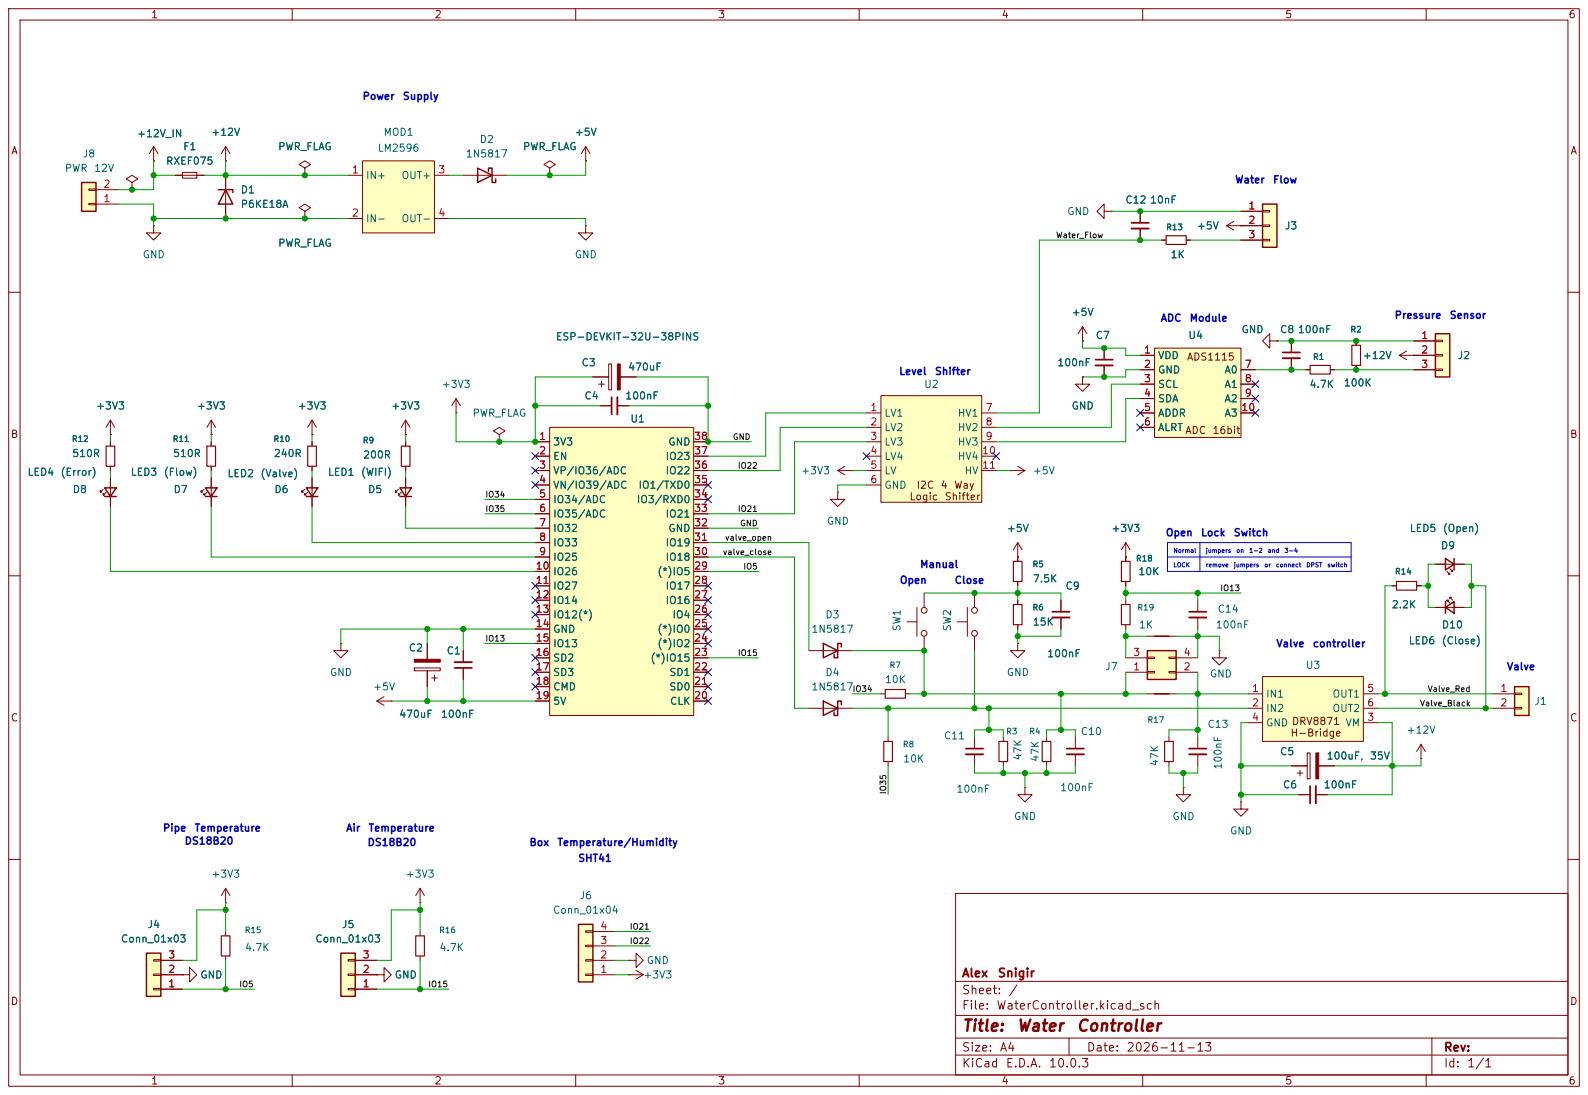
[picture p1: page 1]

Valve controller ADC Module Water Flow
Water_Flow

Open Lock Switch Manual Open DS18B20

Size: A4 | Rev:
KiCad E.D.A. 10.0.3 | Id: 1/1
