alex-snigir/water-controller/WaterController_pio/src/alarms.cpp

#include "lib/MqttClient.h"
#include "main.h"

// Warnings from the temperature and pressure readings. Home Assistant sends the notifications;
// nothing here acts on the valve. Each alarm has a hysteresis, so it does not chatter at the threshold.
#define FREEZE_ON_C             3.0f  // Pipe below: risk of freezing
#define FREEZE_OFF_C            4.0f
#define OVERHEAT_ON_C           55.0f // Controller box above: electronics overheat
#define OVERHEAT_OFF_C          50.0f
#define CONDENSATION_ON_C       2.0f  // Air temperature minus box dew point below: risk of condensation
#define CONDENSATION_OFF_C      3.0f

// The pressure sensor is downstream of the valve (about 4 bar after the reducer). With the valve closed
// the house pressure may fall to 0 legitimately; with it open, 0 means a broken sensor wire,
// no sensor power, no mains water or a burst pipe. A broken wire reads 0 V, the same as 0 bar.
#define LOW_PRESSURE_ON_BAR     0.5f
#define LOW_PRESSURE_OFF_BAR    1.0f
#define LOW_PRESSURE_SETTLE_MS  30000L // After the valve reports open, before the pressure is judged
#define LOW_PRESSURE_HOLD_MS    30000L // Low this long (3 readings at 10 s) before the alarm

#define ERROR_LED_ON            LOW   // LED cathode is on the pin
#define ERROR_LED_OFF           HIGH
#define ERROR_LED_FAULT_MS      1000  // Half period of the slow blink on a sensor fault
#define ERROR_LED_BLOCKED_PERIOD 2000 // Opening banned (J7 or valve_enable): a double flash every 2 s
#define ERROR_LED_BLOCKED_FLASH  100
#define ERROR_LED_BLOCKED_GAP    150
// A rejected open. Long blinks for "disabled", so they do not read as the double flash of a ban.
#define ERROR_LED_LOCKED_MS      150  // "locked" (J7): 3 fast blinks, half period
#define ERROR_LED_LOCKED_BLINKS  3
#define ERROR_LED_DISABLED_MS    400  // "disabled" (valve_enable = 0): 2 long blinks, half period
#define ERROR_LED_DISABLED_BLINKS 2

enum AlarmState { ALARM_UNKNOWN, ALARM_OFF, ALARM_ON };

struct Alarm
{
    const char *name;
    const char *topic;
    AlarmState state;
    bool active;        // Last known on/off: kept while unknown, so the hysteresis survives a sensor fault
};

static Alarm freezeAlarm       = {"freeze",       TOPIC_ALARM_FREEZE,       ALARM_UNKNOWN, false};
static Alarm overheatAlarm     = {"overheat",     TOPIC_ALARM_OVERHEAT,     ALARM_UNKNOWN, false};
static Alarm condensationAlarm = {"condensation", TOPIC_ALARM_CONDENSATION, ALARM_UNKNOWN, false};
static Alarm lowPressureAlarm  = {"low_pressure", TOPIC_ALARM_LOW_PRESSURE, ALARM_UNKNOWN, false};
static Alarm *alarms[] = {&freezeAlarm, &overheatAlarm, &condensationAlarm, &lowPressureAlarm};

static bool valveWasOpen = false;
static unsigned long valveOpenSince = 0L;
static bool pressureWasLow = false;
static unsigned long pressureLowSince = 0L;

static bool rejectBlink = false;
static unsigned long rejectBlinkSince = 0L;
static unsigned long rejectBlinkMs = ERROR_LED_LOCKED_MS;  // Half period of the current pattern
static unsigned long rejectBlinks = ERROR_LED_LOCKED_BLINKS;

static const char *alarm_state_name(AlarmState state)
{
    switch (state) {
    case ALARM_ON:  return "on";
    case ALARM_OFF: return "off";
    default:        return "unknown";
    }
}

// Retained: "unknown" while a sensor it needs has no valid reading, so a missing sensor does not read as "off"
static void alarm_publish(const Alarm &a)
{
    mqttClient.publish(a.topic, alarm_state_name(a.state), true);
}

void alarms_publish()
{
    for (Alarm *a : alarms) {
        alarm_publish(*a);
    }
}

static void alarm_set(Alarm &a, AlarmState state)
{
    if (state == a.state) {
        return;
    }
    a.state = state;
    Serial.printf("Alarm %s: %s\n", a.name, alarm_state_name(state));
    alarm_publish(a);
}

// An active alarm clears only past its off threshold, an inactive one starts at the on threshold.
// After "unknown" the alarm goes on from its last known state.
static void alarm_eval(Alarm &a, bool valid, bool onCondition, bool offCondition)
{
    if (!valid) {
        alarm_set(a, ALARM_UNKNOWN);
        return;
    }
    a.active = a.active ? !offCondition : onCondition;
    alarm_set(a, a.active ? ALARM_ON : ALARM_OFF);
}

static void low_pressure_eval(unsigned long now)
{
    float bar = 0;
    bool valid = pressure_value(&bar);
    bool open = valve_is_open();

    if (open && !valveWasOpen) {
        valveOpenSince = now;
    }
    valveWasOpen = open;

    bool low = valid && bar < LOW_PRESSURE_ON_BAR;
    if (low && !pressureWasLow) {
        pressureLowSince = now;
    }
    pressureWasLow = low;

    if (valid && !open) {
        lowPressureAlarm.active = false; // Closed or unknown valve: low pressure is not a fault
        alarm_set(lowPressureAlarm, ALARM_OFF);
        return;
    }
    bool onCondition = open && now - valveOpenSince >= LOW_PRESSURE_SETTLE_MS &&
                       low && now - pressureLowSince >= LOW_PRESSURE_HOLD_MS;
    alarm_eval(lowPressureAlarm, valid, onCondition, bar > LOW_PRESSURE_OFF_BAR);
}

void alarms_init()
{
    digitalWrite(ERROR_LED, ERROR_LED_OFF);
    pinMode(ERROR_LED, OUTPUT);
}

// A rejected open, over any other pattern: "locked" (command or SW1 under J7) - 3 fast blinks,
// "disabled" (command with valve_enable = 0) - 2 long blinks
void alarms_led_rejected(OpenReject reason)
{
    bool locked = (reason == OPEN_REJECT_LOCKED);
    rejectBlinkMs = locked ? ERROR_LED_LOCKED_MS : ERROR_LED_DISABLED_MS;
    rejectBlinks = locked ? ERROR_LED_LOCKED_BLINKS : ERROR_LED_DISABLED_BLINKS;
    rejectBlink = true;
    rejectBlinkSince = millis();
}

// LED4, highest priority first: blinks after a rejected open (3 fast: locked, 2 long: disabled); on while any alarm is active;
// slow blink on a sensor fault; double flash every 2 s while opening is banned; off otherwise
static void error_led_handle(unsigned long now)
{
    bool on = false;
    bool alarm = false;
    for (Alarm *a : alarms) {
        alarm = alarm || a->state == ALARM_ON;
    }
    if (alarm) {
        on = true;
    } else if (temperature_faulty() || box_faulty()) {
        on = (now / ERROR_LED_FAULT_MS) & 1;
    } else if (valve_open_blocked()) {
        unsigned long phase = now % ERROR_LED_BLOCKED_PERIOD;
        on = phase < ERROR_LED_BLOCKED_FLASH ||
             (phase >= ERROR_LED_BLOCKED_FLASH + ERROR_LED_BLOCKED_GAP &&
              phase < 2 * ERROR_LED_BLOCKED_FLASH + ERROR_LED_BLOCKED_GAP);
    }

    if (rejectBlink) {
        unsigned long elapsed = now - rejectBlinkSince;
        if (elapsed < 2UL * rejectBlinkMs * rejectBlinks) {
            on = ((elapsed / rejectBlinkMs) & 1) == 0;
        } else {
            rejectBlink = false;
        }
    }
    digitalWrite(ERROR_LED, on ? ERROR_LED_ON : ERROR_LED_OFF);
}

// Cheap enough for every loop(): the readings it uses change every 10 s at most
void alarms_handle()
{
    unsigned long now = millis();
    float pipe = 0, air = 0, box = 0, dewpoint = 0; // Only used when the matching *Valid is true
    bool pipeValid = temperature_value(TEMP_PROBE_PIPE, &pipe);
    bool airValid = temperature_value(TEMP_PROBE_AIR, &air);
    bool boxValid = box_value(&box, &dewpoint);

    alarm_eval(freezeAlarm, pipeValid, pipe < FREEZE_ON_C, pipe > FREEZE_OFF_C);
    alarm_eval(overheatAlarm, boxValid, box > OVERHEAT_ON_C, box < OVERHEAT_OFF_C);
    alarm_eval(condensationAlarm, airValid && boxValid,
               air - dewpoint < CONDENSATION_ON_C, air - dewpoint > CONDENSATION_OFF_C);
    low_pressure_eval(now);

    error_led_handle(now);
}

void alarms_debug_info()
{
    Serial.println("\nalarms.cpp:\n===========");
    for (Alarm *a : alarms) {
        Serial.printf("%s: %s\n", a->name, alarm_state_name(a->state));
    }
    Serial.printf("Sensor fault: %d\n", temperature_faulty() || box_faulty());
    Serial.printf("Open blocked: %d\n", valve_open_blocked());
}
