alex-snigir/water-controller/(commit log)

2026-10-31 topics fixes; water-connection-project-summary.md; pressure_sensor range
    [Valve Controller module - v1 - DPDT+SPDT Relay Modules.kicad_pcb, Valve Controller module - v1 - DPDT+SPDT Relay Modules.kicad_sch, Valve Controller module - v2 - 2x DPDT Relay Modules.kicad_pcb, Valve Controller module - v2 - 2x DPDT Relay Modules.kicad_sch, WaterController.kicad_pcb, WaterController.kicad_sch]
2026-10-31 valve: valve state suport implemented
2026-10-31 valve: manual open/close buttons implemented
2026-10-31 valve: stop the valve when OTA starts
    OTA blocks loop(), so valve_handle() could not stop the valve on time.
    Added OTAClient::setStartCallback().
    Claude-Session: https://claude.ai/code/session_01MBrL8h7wi4GF9a2wi5TEic
2026-10-31 valve: repeated command must not restart the move
2026-10-31 valve: reverse command delay implemented
    [valve.cpp]
2026-10-31 valve: adding DPDT+SPDT relay unsupport comments, unsigned type fix
    [valve.cpp]
2026-10-31 valve: removing code duplication; _valve_command() added
2026-10-31 valve: using static for internal functions
2026-10-31 flow: mqtt lost handling; flowtotal implemented
2026-10-31 flow: flow/get implemented
2026-10-31 flow: water flow calculation depends on elapsed time
2026-10-31 flow: first interval for water flow calculation fix
    [water_flow.cpp]
2026-10-31 flow: water_flow minor refactoring, static functions, init with arg
2026-10-31 flow: water_flow ISR function refactoring
2026-10-31 pressure: ads I2C errors handled, failed reads and writes no longer publish false or stale values
    [ads.cpp]
2026-10-31 pressure: pressure/status topic implemented, sensor faults reported over MQTT
2026-10-31 pressure: pressure/get replies with the last reading, ADC is read by timer only
2026-10-31 pressure: first reading interval starts at sensor init
2026-10-31 pressure: over_range status added for saturated sensor signal
2026-10-31 pressure: published value limited to 2 decimals
2026-10-31 pressure: internal variables made static, unused default interval removed
2026-10-31 ads: ADC counted as lost after 3 failed samples in a row, address probe removed
    [ads.cpp, main.h, pressure_sensor.cpp]
2026-10-31 ads: I2C bus recovery and ADC reset added to the reinitialization retry
    [ads.cpp]
2026-10-31 ads: conversion timeout follows data rate, I2C address and pins set in one place
2026-10-31 ads: ADC range log works for any gain
2026-10-31 main: sketch size cached at boot, getSketchSize() no longer stalls loop on info requests
    [debug.cpp, main.cpp, main.h]
2026-10-31 valve: console restart stops a moving valve and publishes unknown state first
2026-10-31 debug: valve_info and sensors_info console commands added, also printed by info
2026-10-31 debug: info prints the same corrected boot time as MQTT
    [debug.cpp, main.cpp, main.h]
2026-10-31 valve: LED2 shows valve state: on, off, blinking while moving, short flash when unknown
    [pressure_sensor.cpp, valve.cpp, water_flow.cpp]
2026-11-07 summary: add temperature/humidity sensors (DS18B20 on GPIO5/15, SHT41 on I2C), PSU notes, sync with FW 20261031 and INFO.txt
    [WaterController.kicad_sch]
2026-11-07 temperature: DS18B20 implementation
2026-11-07 box: SHT41 box temperature, humidity and dew point over raw I2C, heater on high humidity, SHTC3 option
2026-11-07 box: no_sensor only when the address went unanswered every time; SHTC3 sleeps after a failed measure command
    [box_sensor.cpp]
2026-11-07 box: debug info shows readings only when valid, status publish and heater timer simplified
2026-11-07 box: heater end read checked, incomplete heating logged and retried after the next reading
2026-11-07 box: failure counters run on until a good reading, lasting faults no longer logged as one-off
    [box_sensor.cpp]
2026-11-07 alarms: freeze, overheat and condensation alarms with hysteresis, LED4 on alarm, slow blink on sensor fault
    [Application.h, alarms.cpp, box_sensor.cpp, debug.cpp, main.cpp, main.h, temperature.cpp]
2026-11-08 alarms: hysteresis kept through unknown state, LED and publish use the alarm table
2026-11-08 alarms: low_pressure alarm when the valve is open and pressure stays below 0.5 bar
2026-11-08 summary: add Lock Switch (J7, IO13) and valve_enable implementation spec for firmware
    [WaterController.kicad_sch]
2026-11-08 valve: Lock Switch J7 (IO13, valve/lock) and valve_enable open ban in NVS (valve_enable/set|get), valve/rejected, LED4 indication
2026-11-09 alarms: LED4 tells rejected opens apart, 3 fast blinks for locked, 2 long blinks for disabled
    [WaterController.kicad_sch]
2026-11-09 mqtt: delete retained valve/open, valve/close, valve_enable/set on connect before subscribing; summary: 7.2 p.5, p.11 done, stale 7.3 rows removed
2026-11-13 summary: 12V input (J8, RXEF075, P6KE18A), separate HLK-10M12 board, module footprints assigned
    [WaterController.kicad_sch]
